Gaucho-Rocket-Project/Hotfire-Board/hotfire-board/production/bom.csv

Designator | Footprint | Quantity | Value | LCSC Part #
C1, C15, C18, C21, C26, C29, C30, C31, C36, C37, C38, C41, C42, C44, C45, C46, C47, C48, C49, C50, C51, C52, C53, C54, C55, C60, C61, C66, C67, C68, C74, C75, C76, C78, C79, C9 | 0402 | 36 | 0.1u
C10, C8 | 0805 | 2 | 220n
C11, C2, C20, C22, C24, C3, C5, C6, C72, C73, C77 | 1206 | 11 | 4.7u
C12, C14, C17, C39, C4, C43, C69, C70, C71, C80 | 0603 | 10 | 1u
C13 | 0402 | 1 | 270n
C16 | 0402 | 1 | 100p
C19 | 0603 | 1 | CFF
C23, C25, C27, C28, C32 | 1206 | 5 | 22u
C33, C34 | 0402 | 2 | 10p
C35 | 1210 | 1 | 10u
C40, C56, C57, C58, C59, C62, C63, C64, C65, C7 | 0402 | 10 | 10n
CR1 | Shottkey_Rev_Bat | 1 | B1100-13-F
CR3 | ESDPROTECTION | 1 | USBLC6-2SC6 | USBLC6-2SC6
CR4 | SWD_1_TVS | 1 | SMLVT3V3
CR5 | SWD_4_TVS | 1 | ESDALC6V1W5
CR6, CR7, CR8, CR9 | TVS_Input | 4 | SP1233-01ETG
D1, D12, D13, D14, D15, D16, D17, D18, D19, D2, D20, D21, D22, D23, D26, D27, D28, D29, D3, D30, D31, D32, D33, D34, D35, D36, D4, D5, D8, D9 | SD_ESD | 30 | TPD1E05U06DPYR
D10, D11, D6, D7 | dual_shottkey | 4 | BAT54S
D24 | 15V_TVS | 1 | SMBJ15A
D25 | 18V_TVS | 1 | SMBJ18A
F1 | fuse | 1 | SF-1206S100-2
J1 | AMASS_XT60-M_1x02_P7.20mm_Vertical | 1 | Conn_01x02
J10, J5, J7, J9 | 3-pin-jst | 4 | SM03B-GHS-TB
J11, J12, J13, J14 | screw_terminal | 4 | 1725656
J15 | PinSocket_1x08_P2.54mm_Vertical | 1 | Conn_01x08
J16 | PinSocket_2x06_P2.54mm_Vertical | 1 | C36191
J17 | newSD | 1 | 1040310811
J2 | 3x2_Header | 1 | BCS-103-L-D-TE
J3 | PinSocket_1x04_P2.54mm_Vertical | 1 | UART1
J4 | PinSocket_1x04_P2.54mm_Vertical | 1 | UART3
J6 | USB | 1 | USB4105-GF-A-060 | USB4105-GF-A-060
L1, L2 | 22uH | 2 | IHLP2525CZER220M5A
LED1, LED2, LED3, LED4, LED5, LED6 | red_LED | 6 | LTST-C190KRKT
R1, R14, R15, R28, R29, R35, R42, R61, R71, R79, R91, R92 | 0805 | 12 | 130
R10, R11, R6, R65, R66, R74 | 0402 | 6 | 100k
R12, R37, R38, R39, R40, R63, R69, R72, R75, R76, R77, R78, R9 | 0402 | 13 | 10k
R13 | 0603 | 1 | 400 | PAT0603E4000BST1
R16, R17, R18, R19, R20, R21 | 0402 | 6 | 22
R2, R68 | 0402 | 2 | 590
R22, R23, R24, R27, R32, R33 | 0402 | 6 | 47k
R25, R26, R34, R41 | 1206 | 4 | 20
R3, R4 | 0603 | 2 | 5.1k | 0603WAF5101T5E
R30, R31, R36, R43, R67, R70, R73 | 0402 | 7 | 4.7k
R44, R45, R46, R47, R48, R49, R50, R51, R52, R53, R54, R55, R56, R57, R58, R59, R60, R80, R81, R82, R83, R84, R85, R86, R87, R88, R89, R90 | 0402 | 28 | 100
R5 | 0402 | 1 | 43.2k
R62, R64 | 0402 | 2 | 68.1k
R7 | 0402 | 1 | 24.9k
R8 | 1206 | 1 | 1.3k
SW1 | SWITCH | 1 | RESET
SW2 | SWITCH | 1 | BOOT
U1 | 3.3V_Buck | 1 | LMR36006BRNXR
U10 | Boost_Shottkey | 1 | SS34
U11 | 4-16-Multiplexer | 1 | CD74HC154M96
U12 | eFuse | 1 | TPS26600PWPR
U2 | 15V_Boost | 1 | TPS55340PWPR
U3 | STM32 | 1 | STM32L496RET6
U4 | PowerMUXER. | 1 | TPS2113APW
U5 | newLDO | 1 | TLV75533PDRVR
U6, U7, U8, U9 | MAX | 4 | MAX31856MUD+
Y1 | Crystal_SMD_3225-4Pin_3.2x2.5mm | 1 | 16MHz
