Gaucho-Rocket-Project/Hotfire-Board/hotfire-board/Hotfire-Board/Project Libraries/My3DModels/18V_TVS.stp

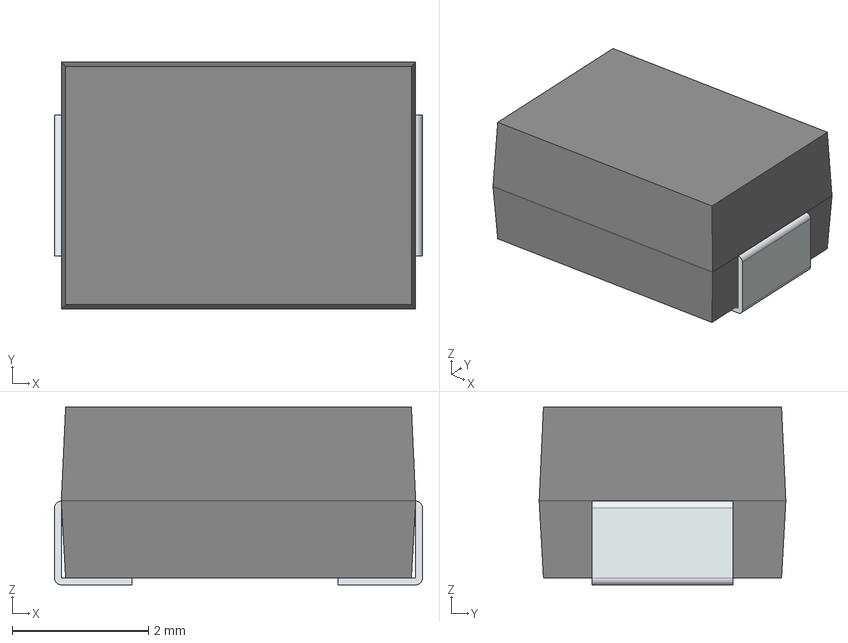
[picture p35: CAD file, 2026-10-14]
hotfire-board/Hotfire-Board/Project Libraries/My3DModels/18V_TVS.stp
5.40 x 3.62 x 2.61 mm
FilletPin1
FilletPin2
