Gaucho-Rocket-Project/Hotfire-Board/hotfire-board/Project Libraries/My3DModels/Boost_Shottkey.step

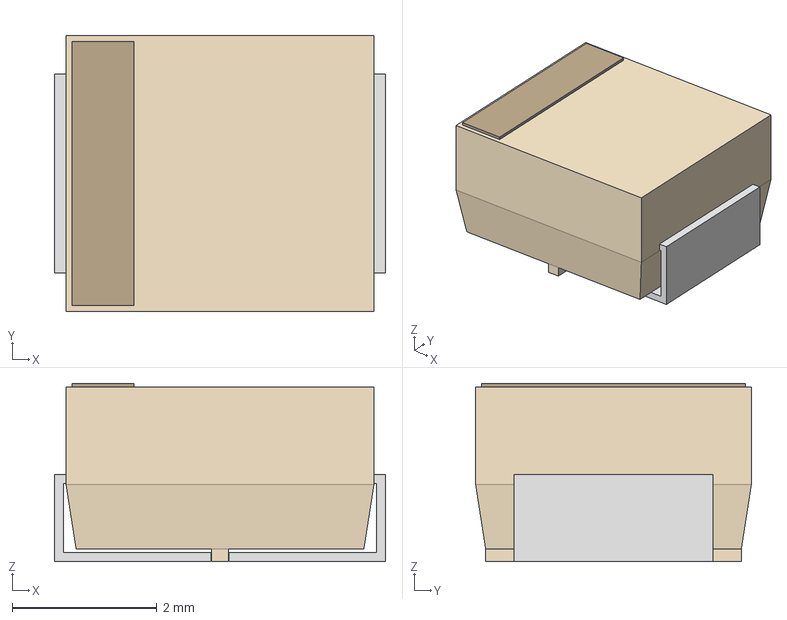
[picture p36: CAD file, 2026-11-07]
hotfire-board/Project Libraries/My3DModels/Boost_Shottkey.step
4.57 x 3.81 x 2.46 mm
