Gaucho-Rocket-Project/Hotfire-Board/hotfire-board/Hotfire-Board/Project Libraries/My3DModels/SD_ESD.step

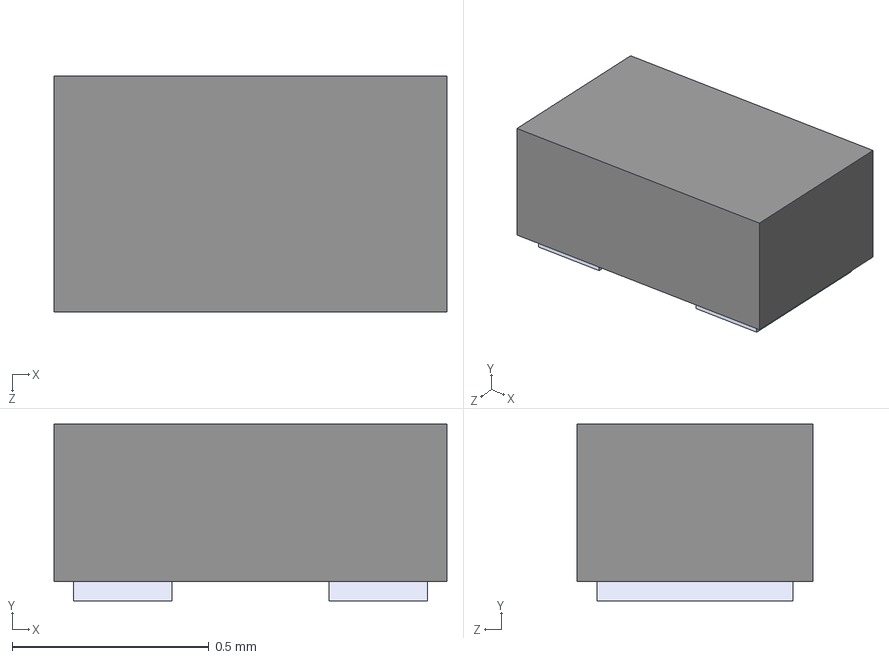
[picture p37: CAD file, 2026-10-08]
hotfire-board/Hotfire-Board/Project Libraries/My3DModels/SD_ESD.step
1.00 x 0.45 x 0.6 mm
