Gaucho-Rocket-Project/Hotfire-Board/hotfire-board/Project Libraries/My3DModels/TVS_Input.step

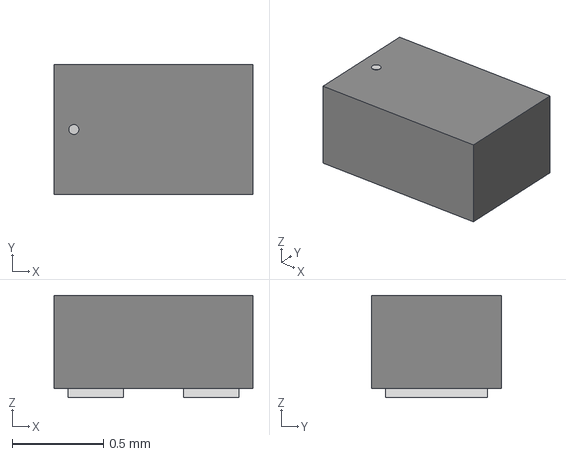
[picture p38: CAD file, 2026-10-08]
hotfire-board/Project Libraries/My3DModels/TVS_Input.step
1.09 x 0.712 x 0.561 mm
