Gaucho-Rocket-Project/Hotfire-Board/hotfire-board/Hotfire-Board/Project Libraries/My3DModels/dual_shottkey.STEP

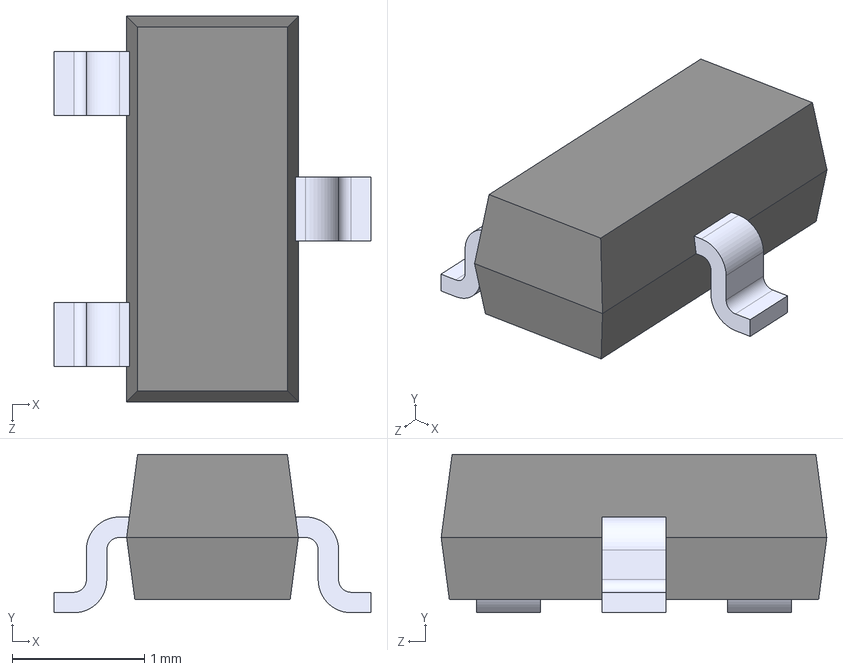
[picture p39: CAD file, 2026-10-08]
hotfire-board/Hotfire-Board/Project Libraries/My3DModels/dual_shottkey.STEP
2.40 x 1.20 x 2.92 mm
