Gaucho-Rocket-Project/Hotfire-Board/hotfire-board/Project Libraries/My3DModels/ESDPROTECTION.step

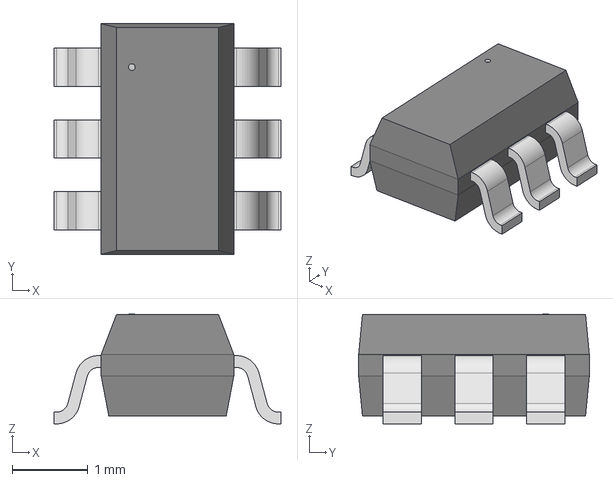
[picture p40: CAD file, 2026-10-07]
hotfire-board/Project Libraries/My3DModels/ESDPROTECTION.step
3.00 x 3.05 x 1.45 mm
