Gaucho-Rocket-Project/Hotfire-Board/hotfire-board/Hotfire-Board/Project Libraries/My3DModels/SD_Card.step

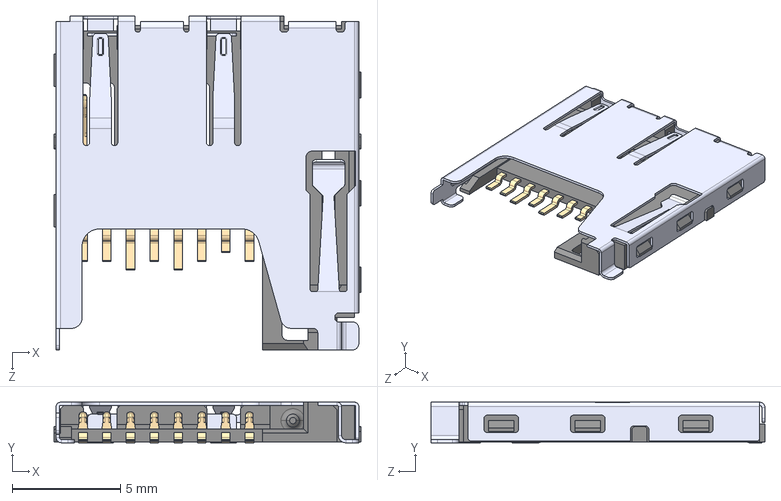
[picture p41: CAD file, 2026-10-08]
hotfire-board/Hotfire-Board/Project Libraries/My3DModels/SD_Card.step
14.2 x 1.88 x 15.4 mm
