Gaucho-Rocket-Project/Hotfire-Board/hotfire-board/Project Libraries/My3DModels/2x3_Header.stp

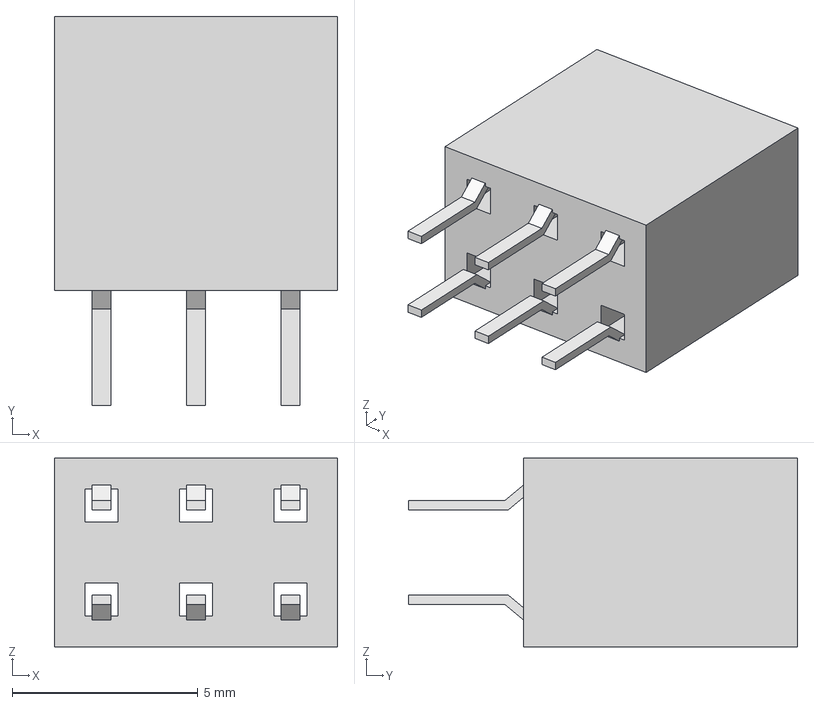
[picture p42: CAD file, 2026-10-07]
hotfire-board/Project Libraries/My3DModels/2x3_Header.stp
7.62 x 10.5 x 5.08 mm
BCS-103-D-TE_socket
C-95-01-03-L-D-TE
C-95-01-03-L-D-TE2
