Gaucho-Rocket-Project/Hotfire-Board/hotfire-board/Hotfire-Board/Project Libraries/My3DModels/red_LED.step

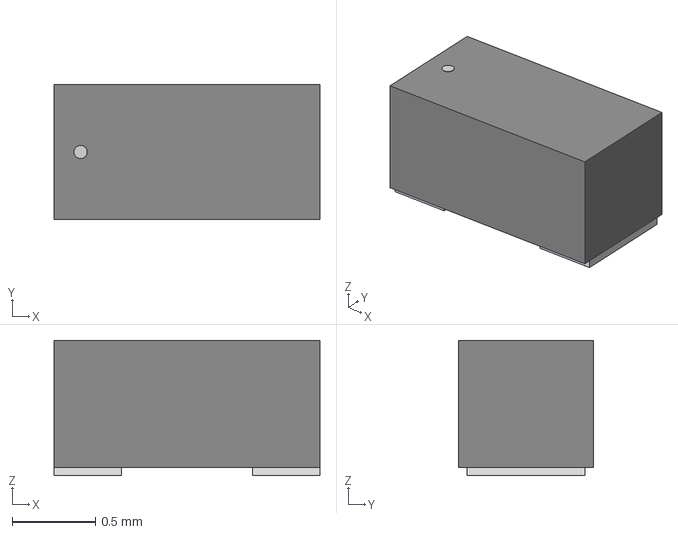
[picture p43: CAD file, 2026-10-07]
hotfire-board/Hotfire-Board/Project Libraries/My3DModels/red_LED.step
1.60 x 0.812 x 0.815 mm
