Gaucho-Rocket-Project/Hotfire-Board/hotfire-board/Hotfire-Board/Project Libraries/My3DModels/USB.step

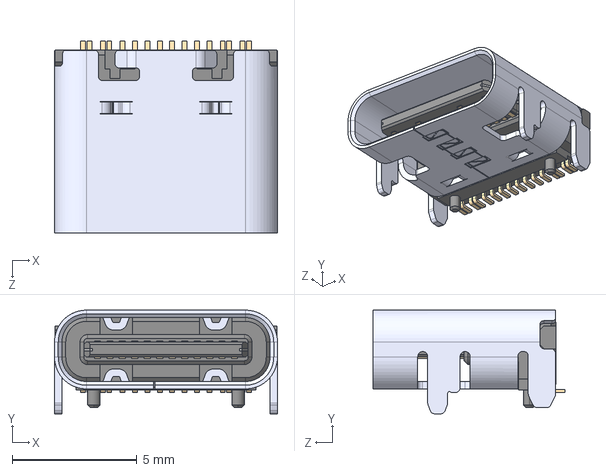
[picture p44: CAD file, 2026-10-07]
hotfire-board/Hotfire-Board/Project Libraries/My3DModels/USB.step
8.94 x 4.16 x 7.71 mm
