Gaucho-Rocket-Project/Hotfire-Board/hotfire-board/Project Libraries/My3DModels/Switch.step

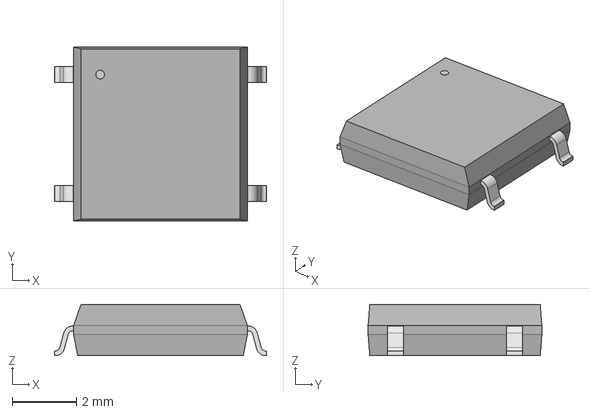
[picture p45: CAD file, 2026-10-07]
hotfire-board/Project Libraries/My3DModels/Switch.step
6.60 x 5.41 x 1.60 mm
