Gaucho-Rocket-Project/Hotfire-Board/hotfire-board/Hotfire-Board/Project Libraries/My3DModels/15uH_Inductor.step

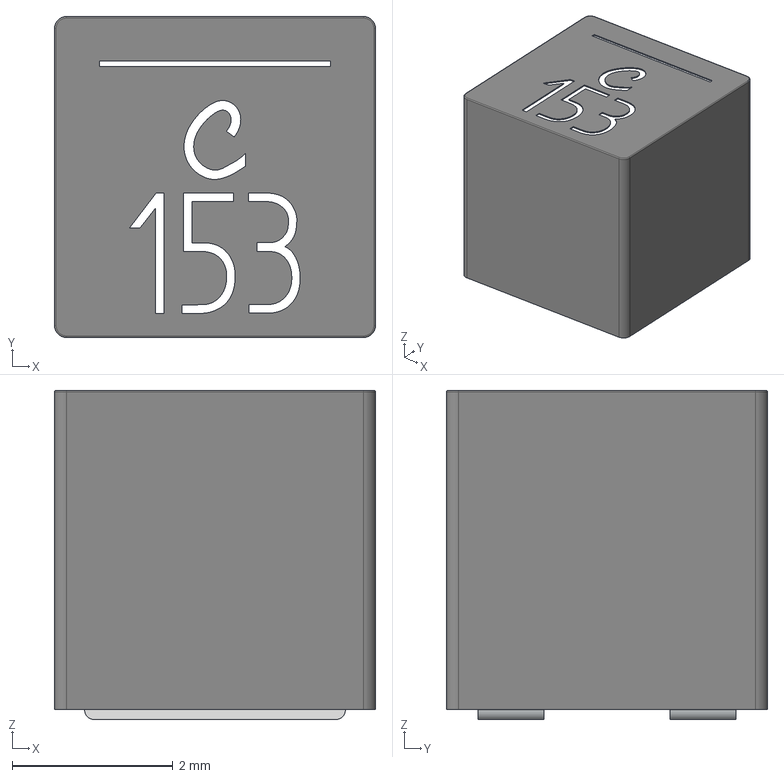
[picture p46: CAD file, 2026-10-07]
hotfire-board/Hotfire-Board/Project Libraries/My3DModels/15uH_Inductor.step
4.00 x 4.00 x 4.10 mm
