Gaucho-Rocket-Project/Hotfire-Board/hotfire-board/Project Libraries/My3DModels/fuse.stp

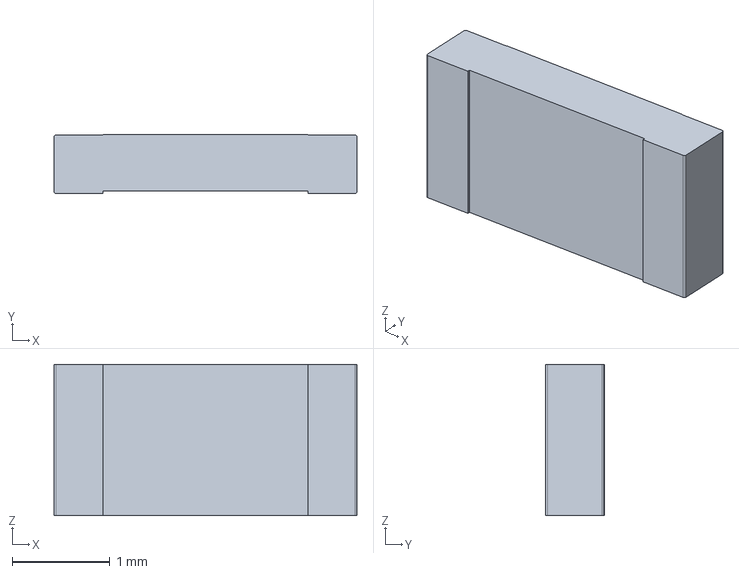
[picture p47: CAD file, 2026-10-07]
hotfire-board/Project Libraries/My3DModels/fuse.stp
3.10 x 0.605 x 1.55 mm
