Gaucho-Rocket-Project/Hotfire-Board/hotfire-board/Hotfire-Board/Project Libraries/My3DModels/PowerMUXER.stp

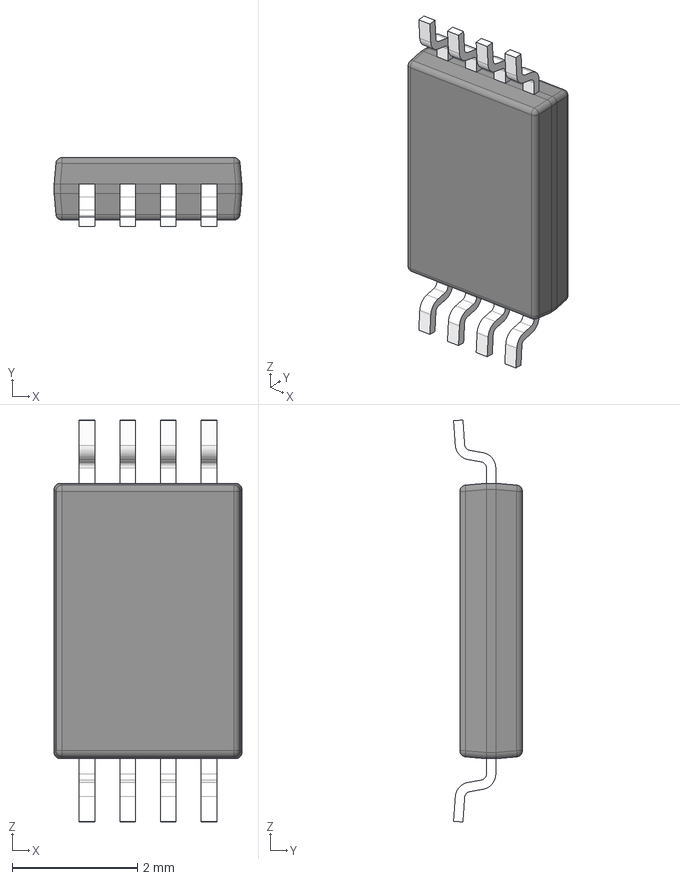
[picture p48: CAD file, 2026-10-07]
hotfire-board/Hotfire-Board/Project Libraries/My3DModels/PowerMUXER.stp
3.00 x 1.10 x 6.42 mm
BODY-SO
LEAD-SO x 8
PIN1-ID
