Gaucho-Rocket-Project/Hotfire-Board/hotfire-board/Project Libraries/My3DModels/SWD_1_TVS.step

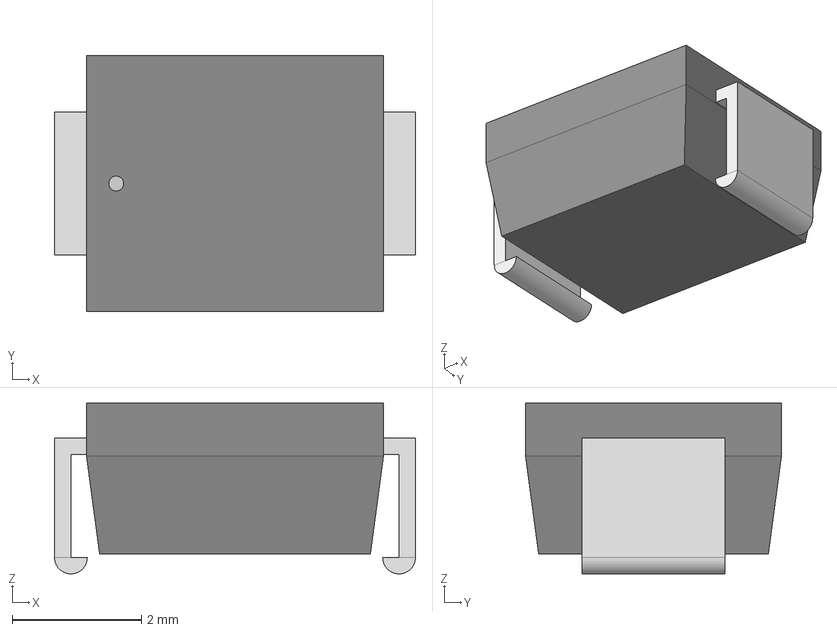
[picture p49: CAD file, 2026-10-07]
hotfire-board/Project Libraries/My3DModels/SWD_1_TVS.step
5.59 x 3.96 x 2.64 mm
