Gaucho-Rocket-Project/Hotfire-Board/hotfire-board/Hotfire-Board/Project Libraries/My3DModels/28V_TVS.step

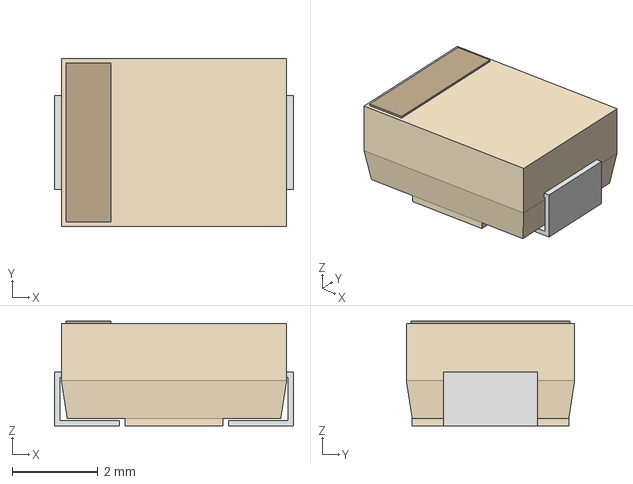
[picture p50: CAD file, 2026-10-07]
hotfire-board/Hotfire-Board/Project Libraries/My3DModels/28V_TVS.step
5.59 x 3.94 x 2.45 mm
