Gaucho-Rocket-Project/Hotfire-Board/hotfire-board/Hotfire-Board/Project Libraries/My3DModels/Shottkey_Rev_Bat.step

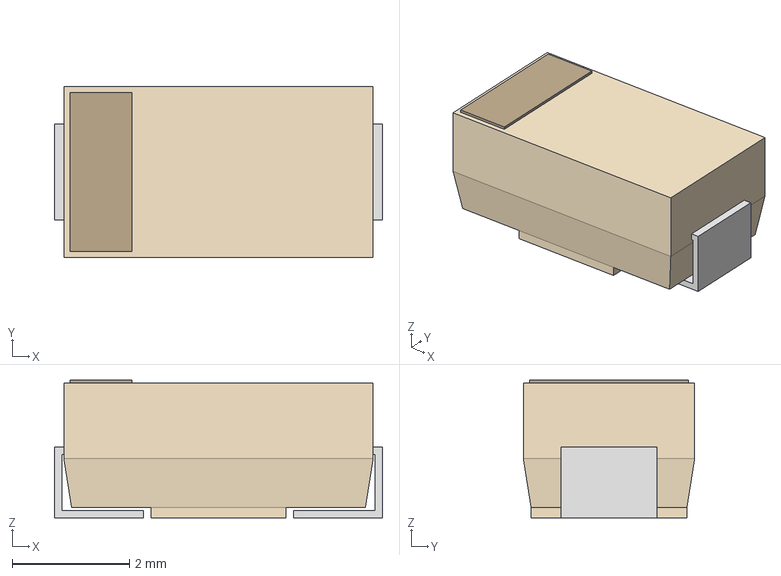
[picture p51: CAD file, 2026-10-07]
hotfire-board/Hotfire-Board/Project Libraries/My3DModels/Shottkey_Rev_Bat.step
5.59 x 2.92 x 2.35 mm
