Gaucho-Rocket-Project/Hotfire-Board/hotfire-board/Hotfire-Board/Project Libraries/My3DModels/MAX.step

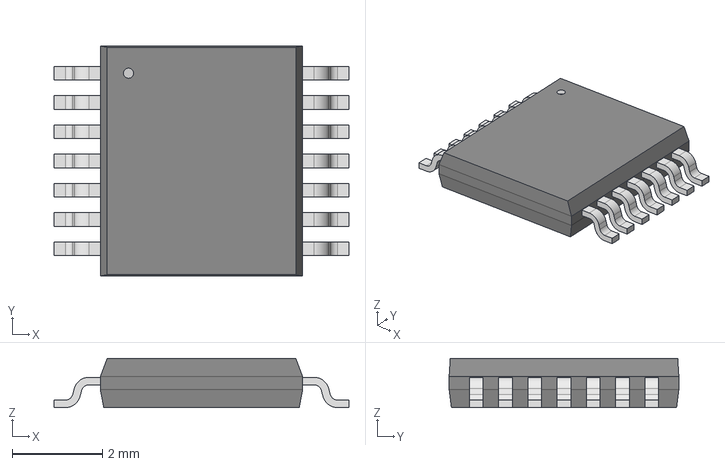
[picture p52: CAD file, 2026-10-07]
hotfire-board/Hotfire-Board/Project Libraries/My3DModels/MAX.step
6.55 x 5.11 x 1.09 mm
