Gaucho-Rocket-Project/Hotfire-Board/hotfire-board/Hotfire-Board/Project Libraries/My3DModels/SWD_4_TVS.step

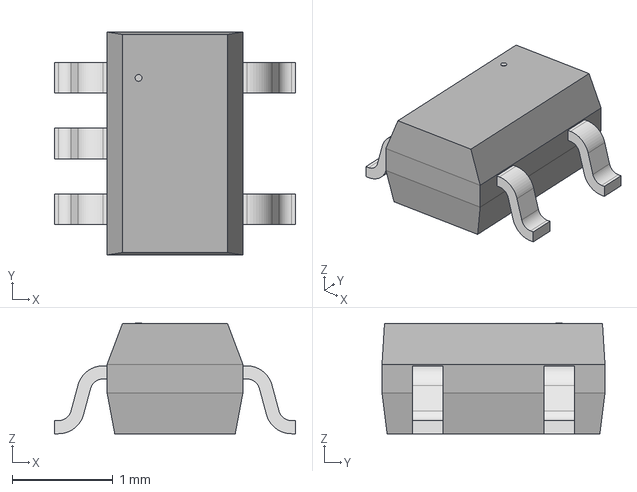
[picture p53: CAD file, 2026-10-07]
hotfire-board/Hotfire-Board/Project Libraries/My3DModels/SWD_4_TVS.step
2.39 x 2.21 x 1.09 mm
