Gaucho-Rocket-Project/Hotfire-Board/hotfire-board/Hotfire-Board/Project Libraries/My3DModels/3.3V_Buck.stp

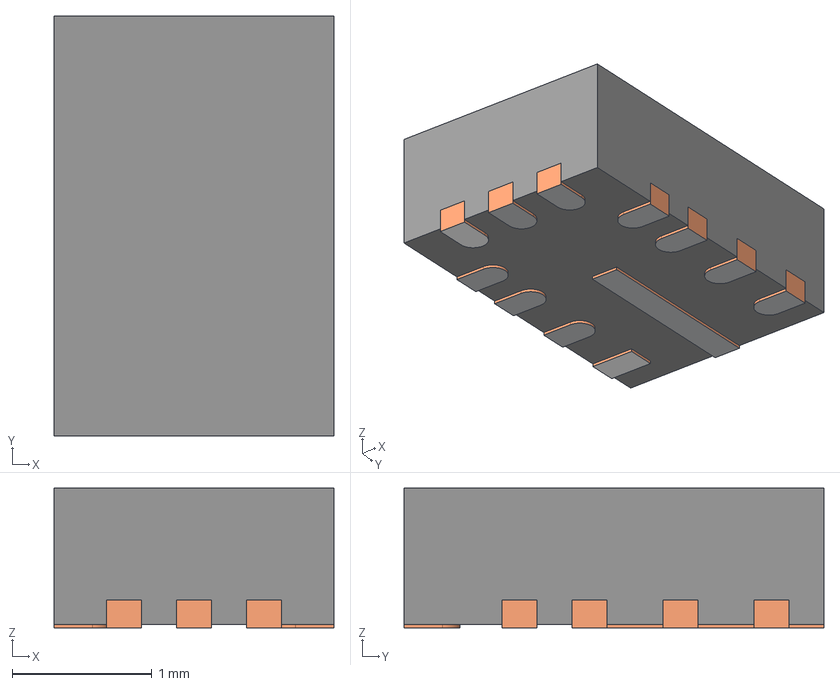
[picture p54: CAD file, 2026-10-07]
hotfire-board/Hotfire-Board/Project Libraries/My3DModels/3.3V_Buck.stp
2.00 x 3.00 x 1.00 mm
FRAME-RNX0012A
BODY-QFN
PIN1-ID
