Gaucho-Rocket-Project/Hotfire-Board/hotfire-board/Hotfire-Board/Project Libraries/My3DModels/LDO.stp

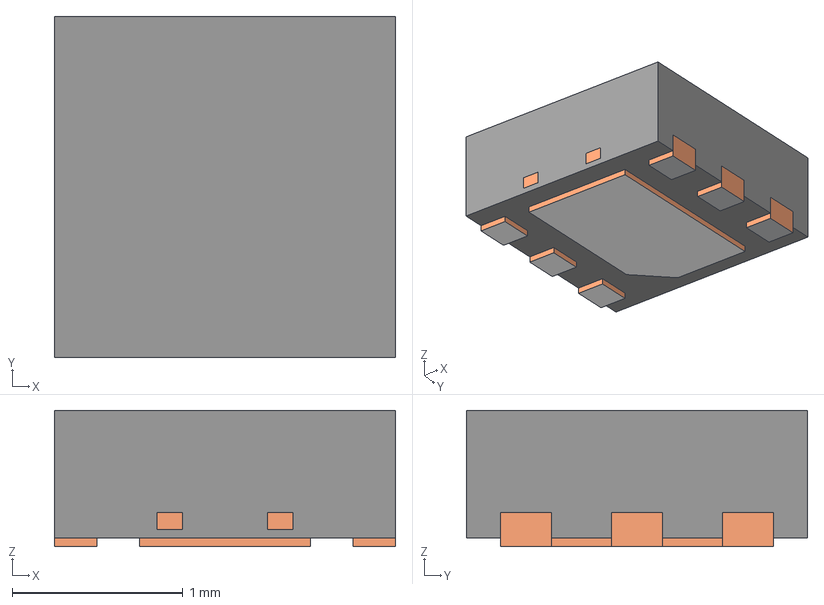
[picture p55: CAD file, 2026-10-07]
hotfire-board/Hotfire-Board/Project Libraries/My3DModels/LDO.stp
2.00 x 2.00 x 0.8 mm
BODY-SON
FRAME-DRV0006A
PIN1-ID
