Gaucho-Rocket-Project/Hotfire-Board/hotfire-board/Hotfire-Board/Project Libraries/My3DModels/STM32.step

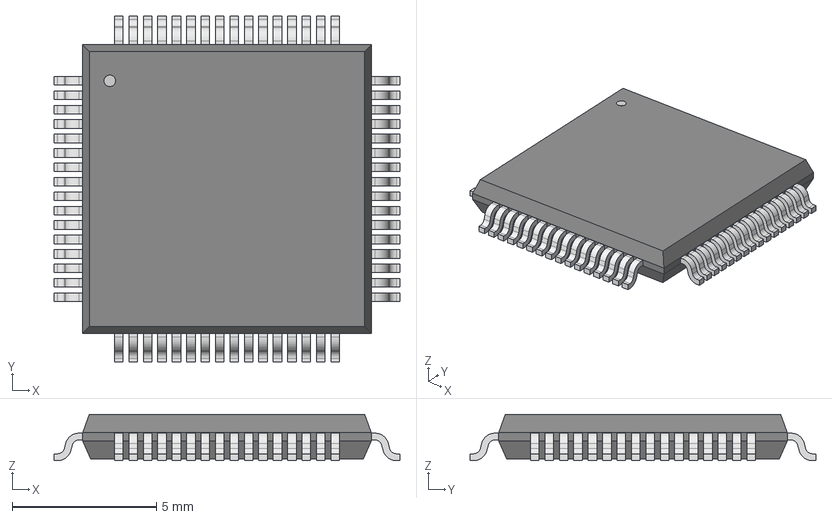
[picture p56: CAD file, 2026-10-07]
hotfire-board/Hotfire-Board/Project Libraries/My3DModels/STM32.step
12.0 x 12.0 x 1.60 mm
