Gaucho-Rocket-Project/Hotfire-Board/(list of files, cad)

Other CAD files:
hotfire-board/Project Libraries/My3DModels/screw_terminal.step
