Gaucho-Rocket-Project/Hotfire-Board/hotfire-board/Hotfire-Board.kicad_pcb

## KiCad design hotfire-board/Hotfire-Board.kicad_pcb (2026-11-07)

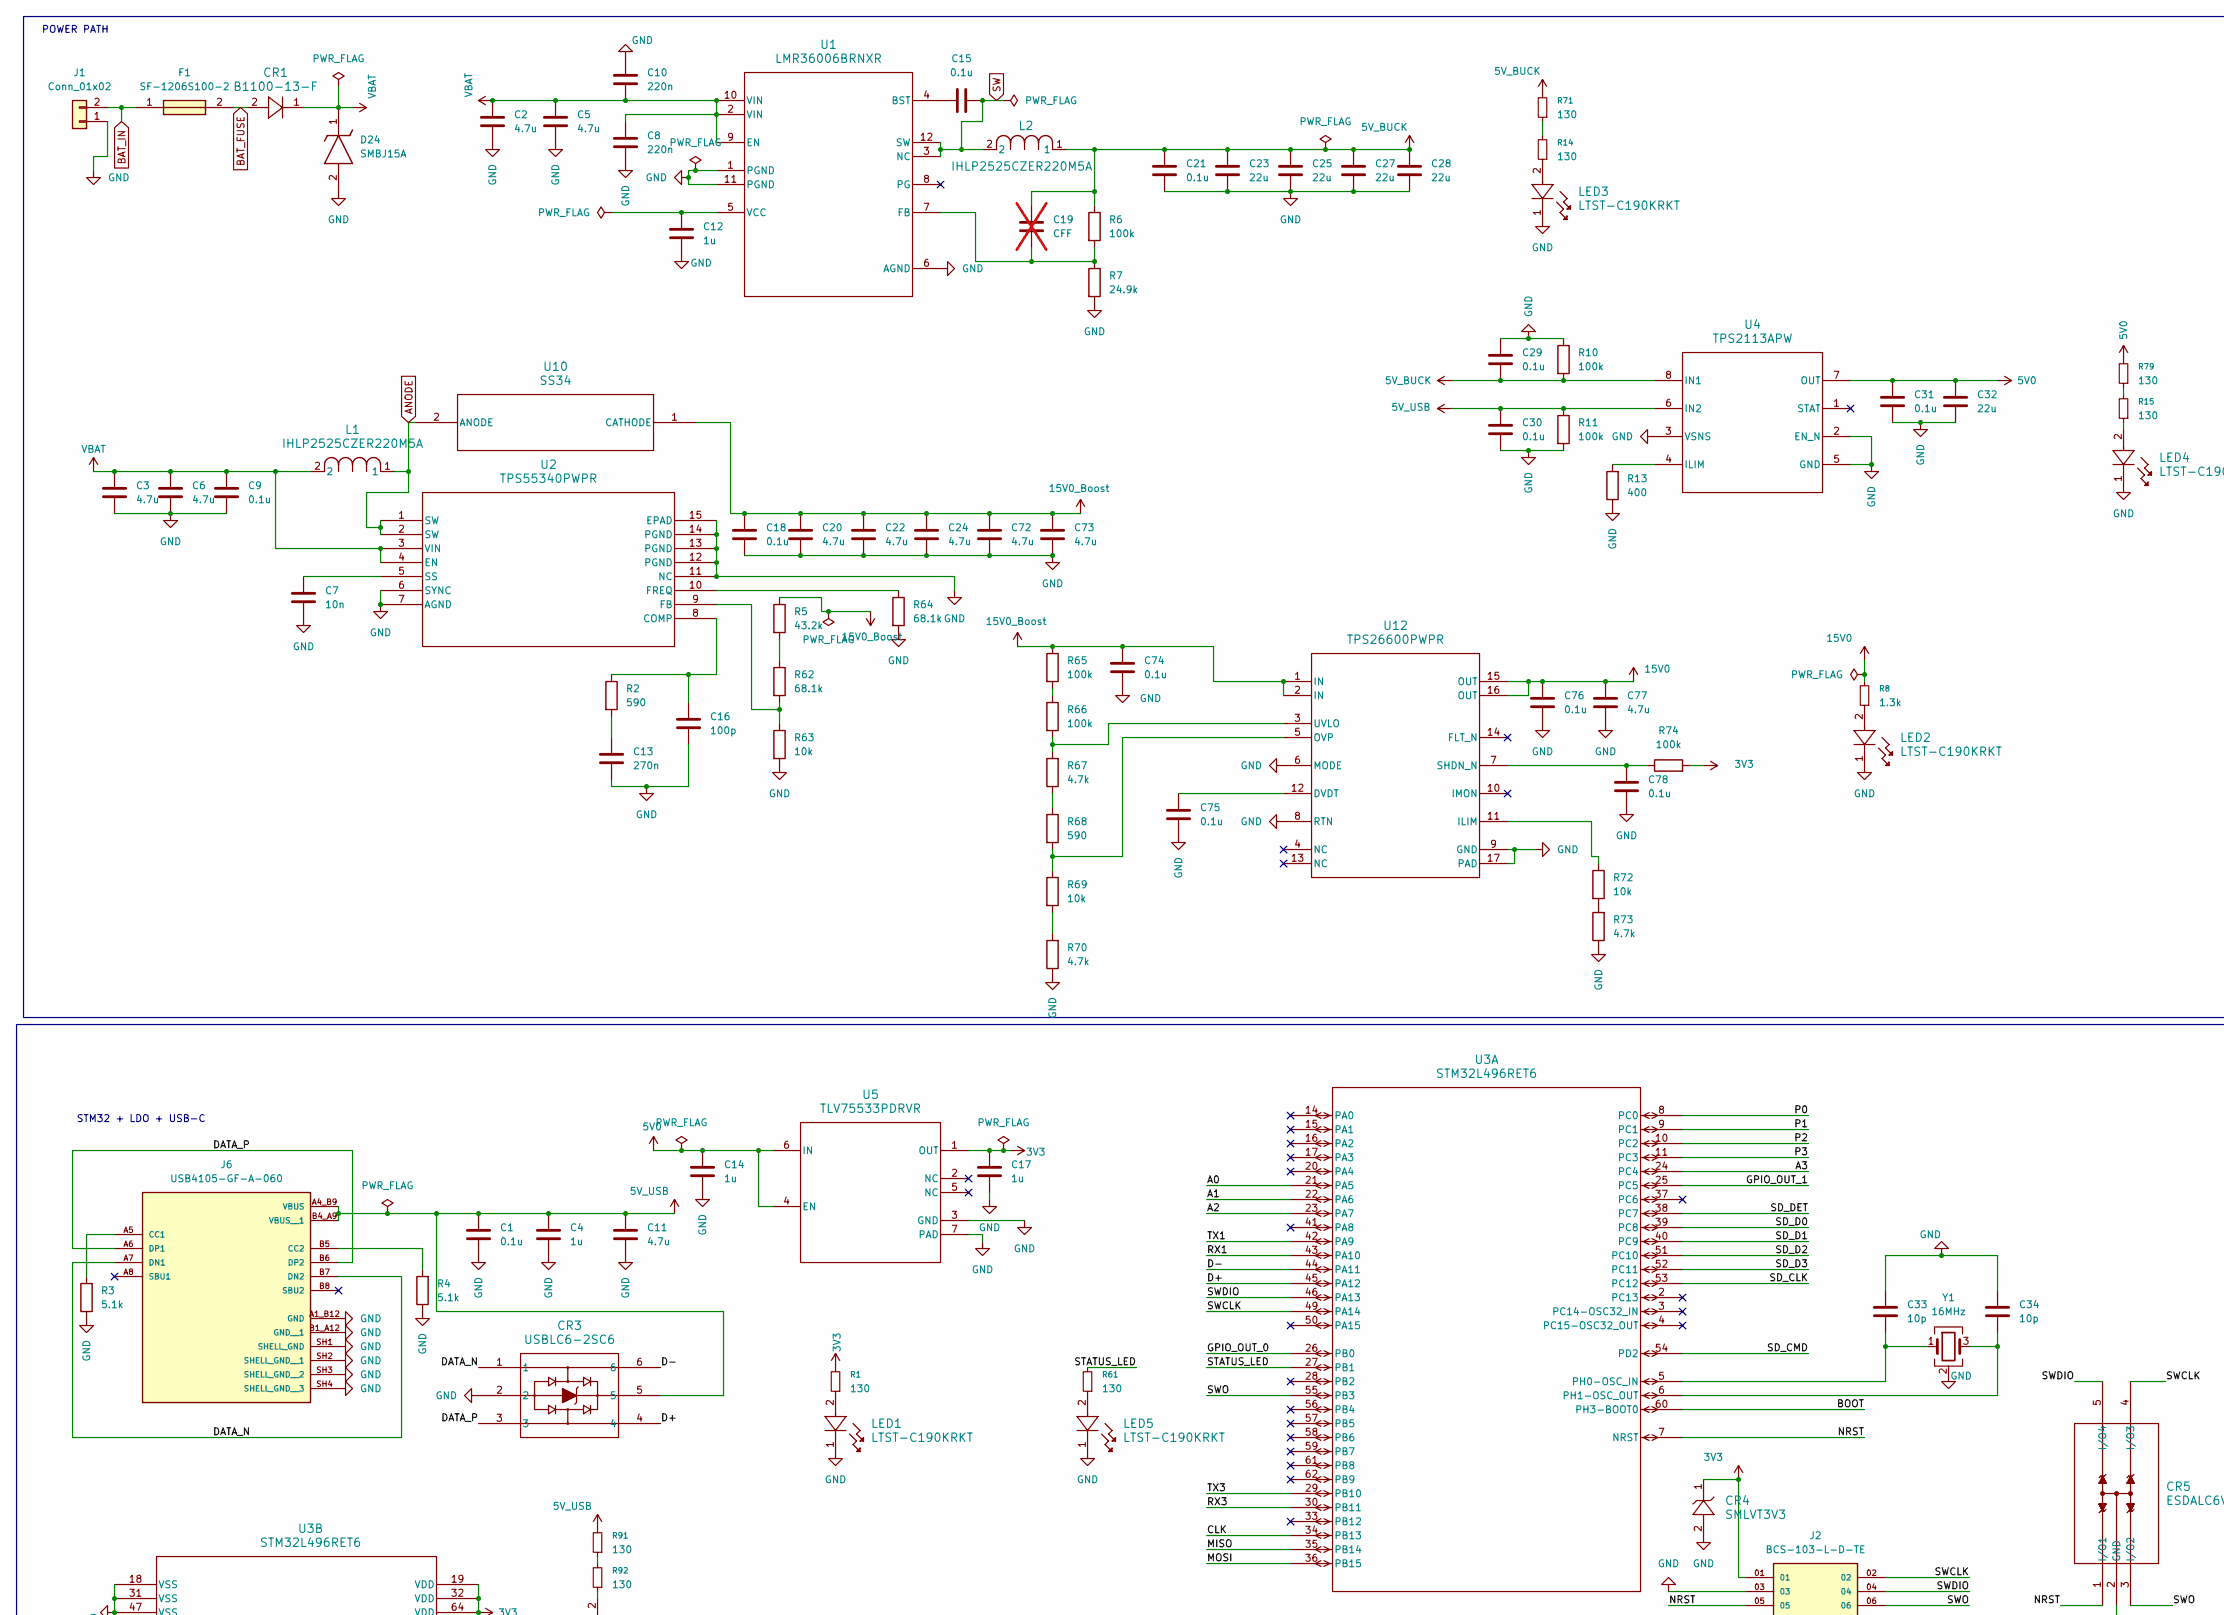
[picture p57: schematic Hotfire-Board.kicad_sch, part in row 1, column 1]

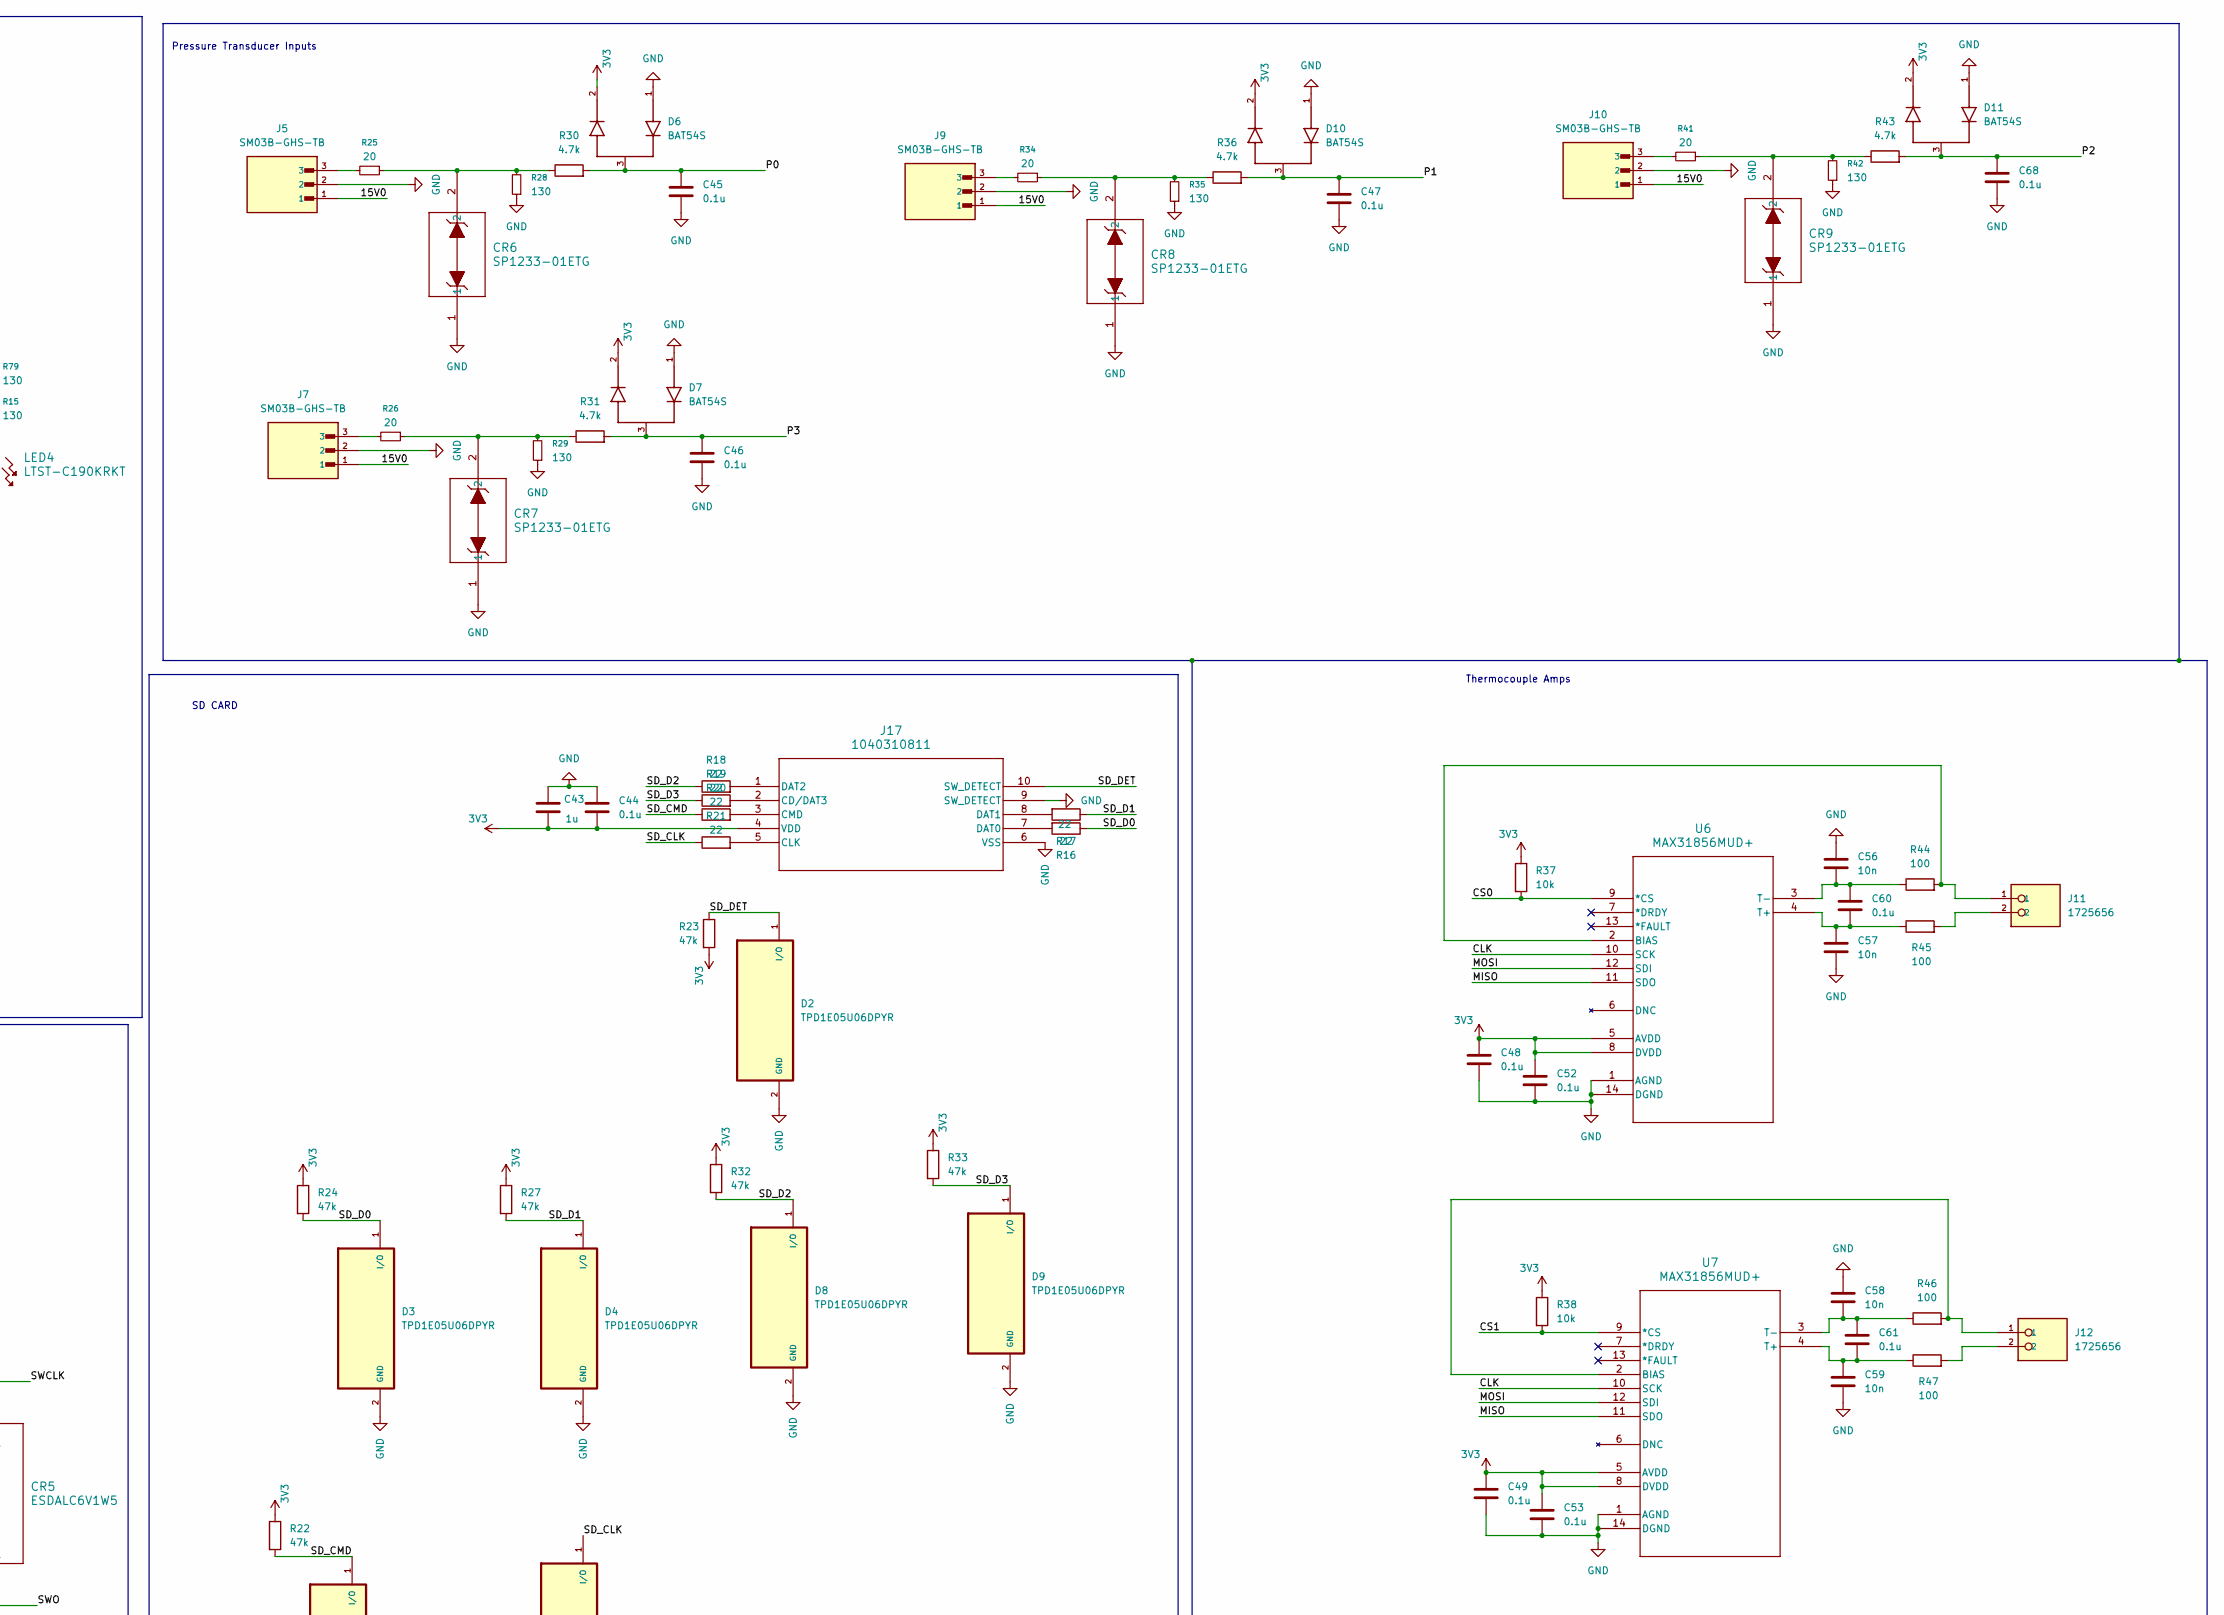
[picture p58: schematic Hotfire-Board.kicad_sch, part in row 1, column 2]

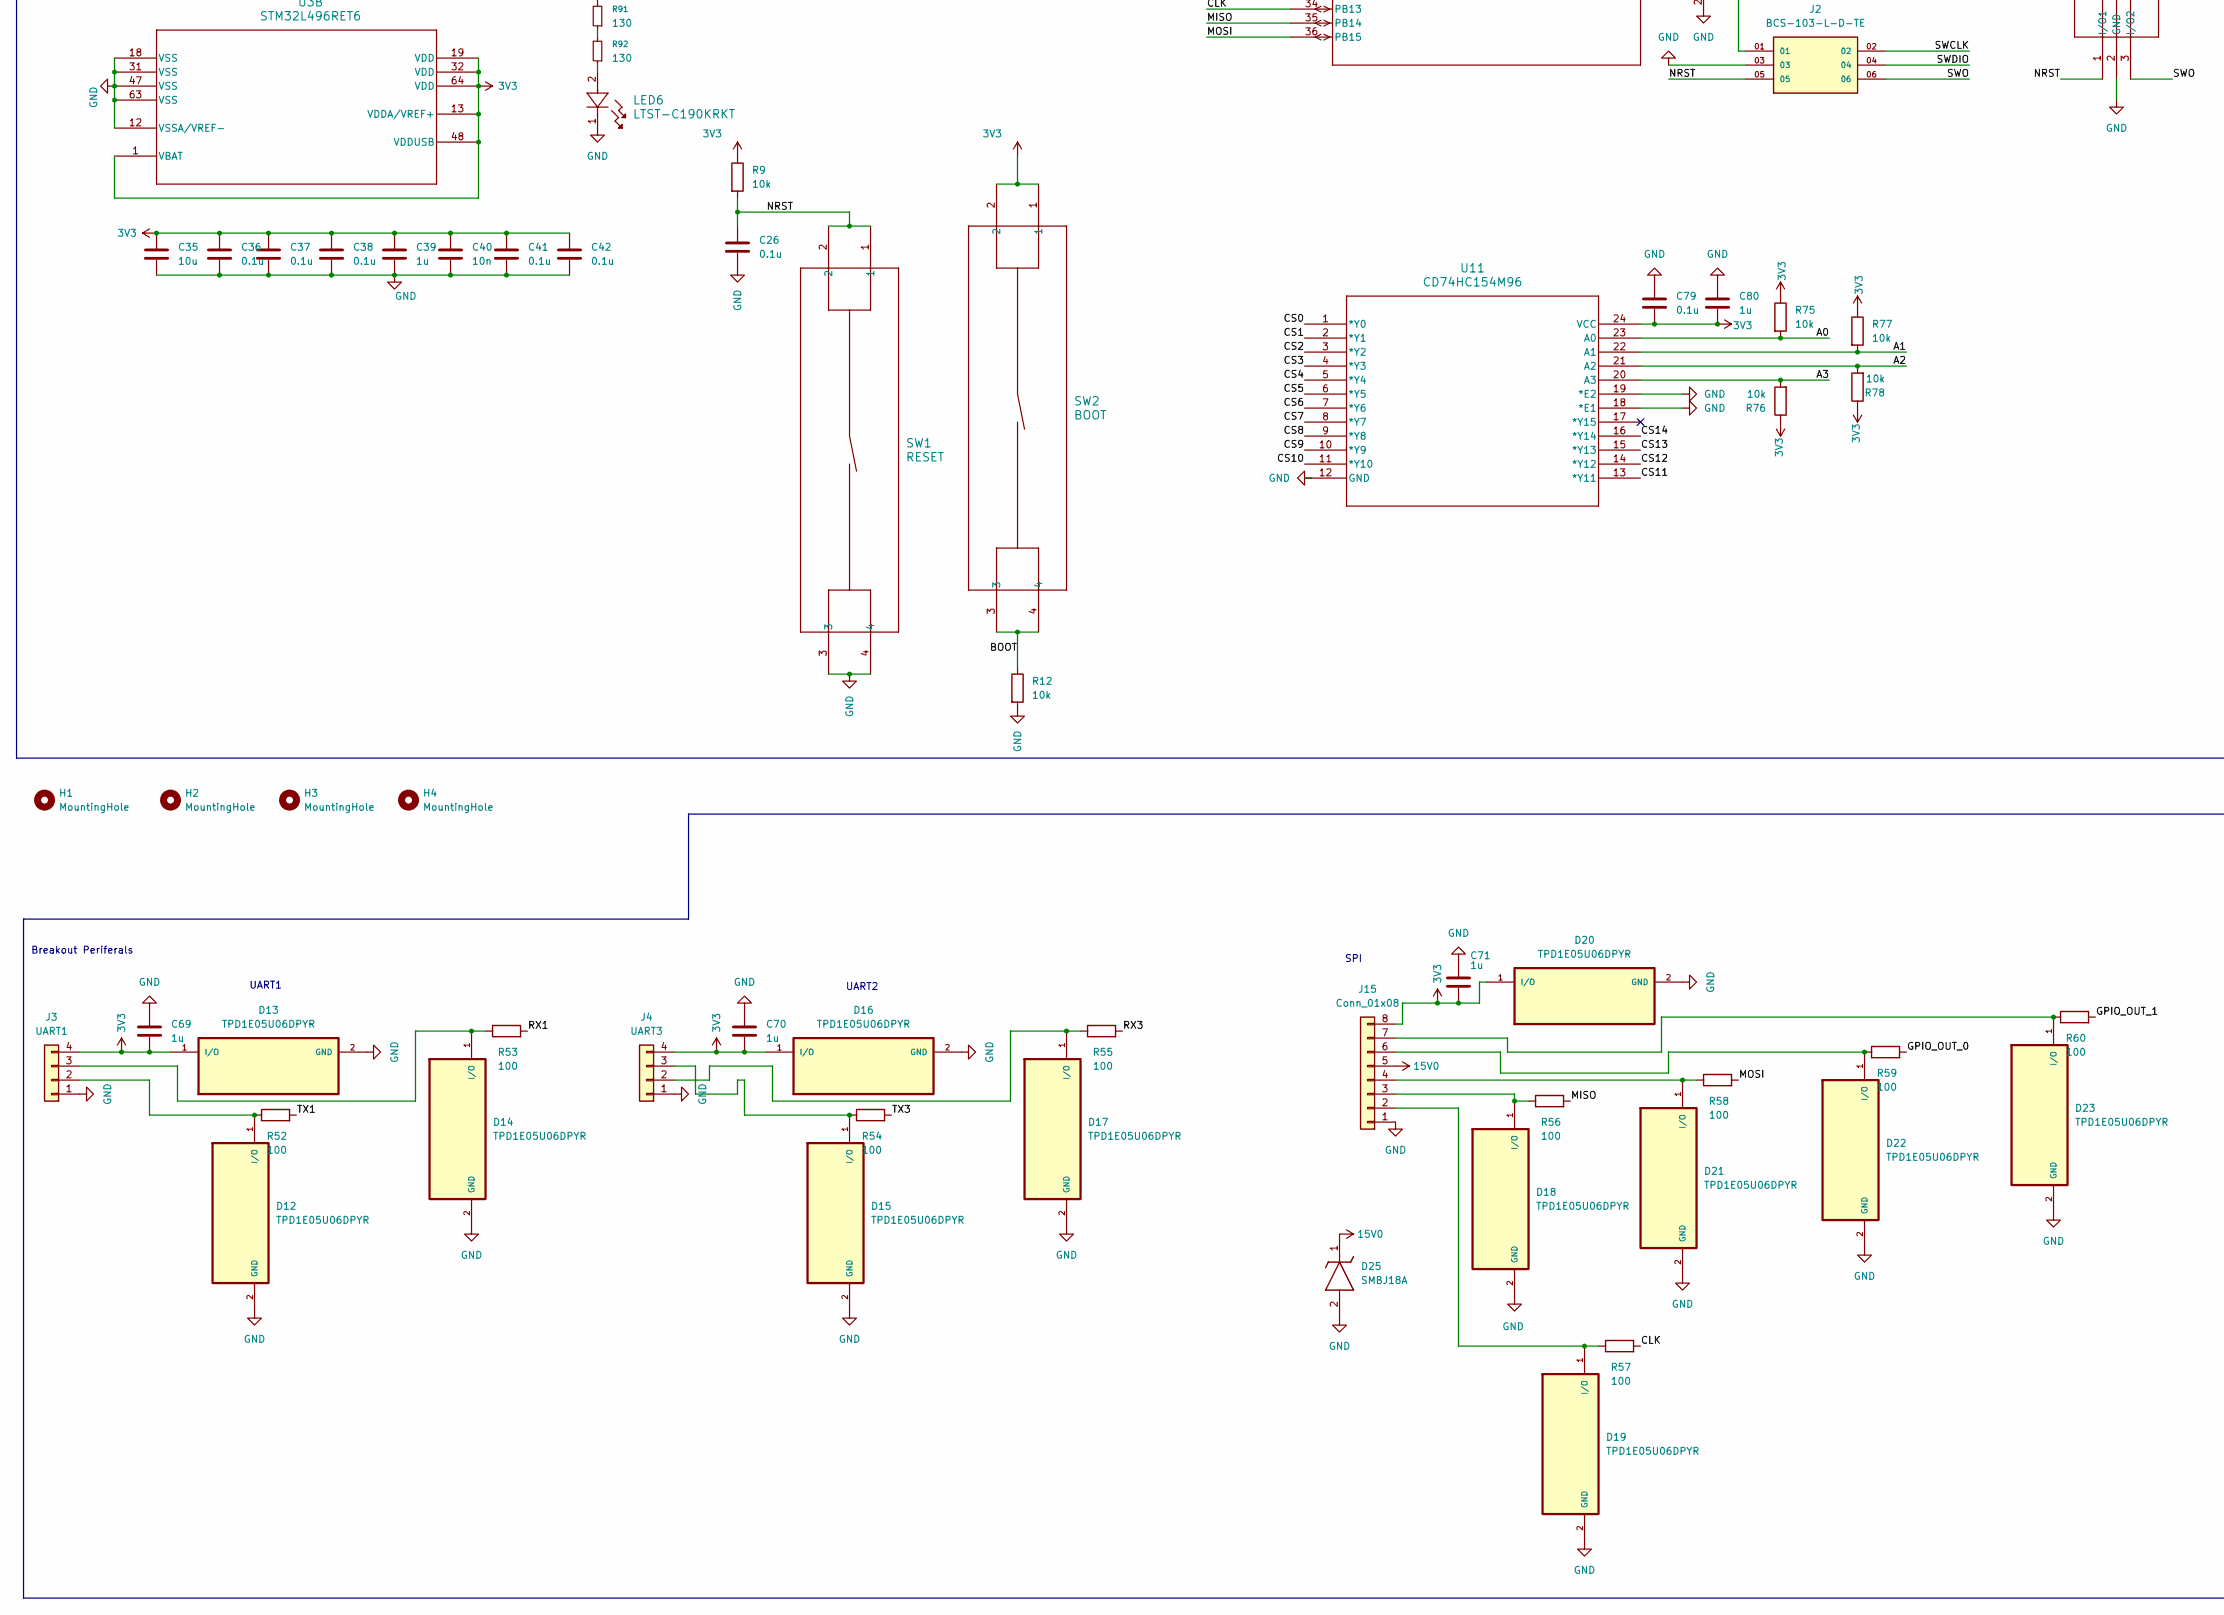
[picture p59: schematic Hotfire-Board.kicad_sch, part in row 2, column 1]

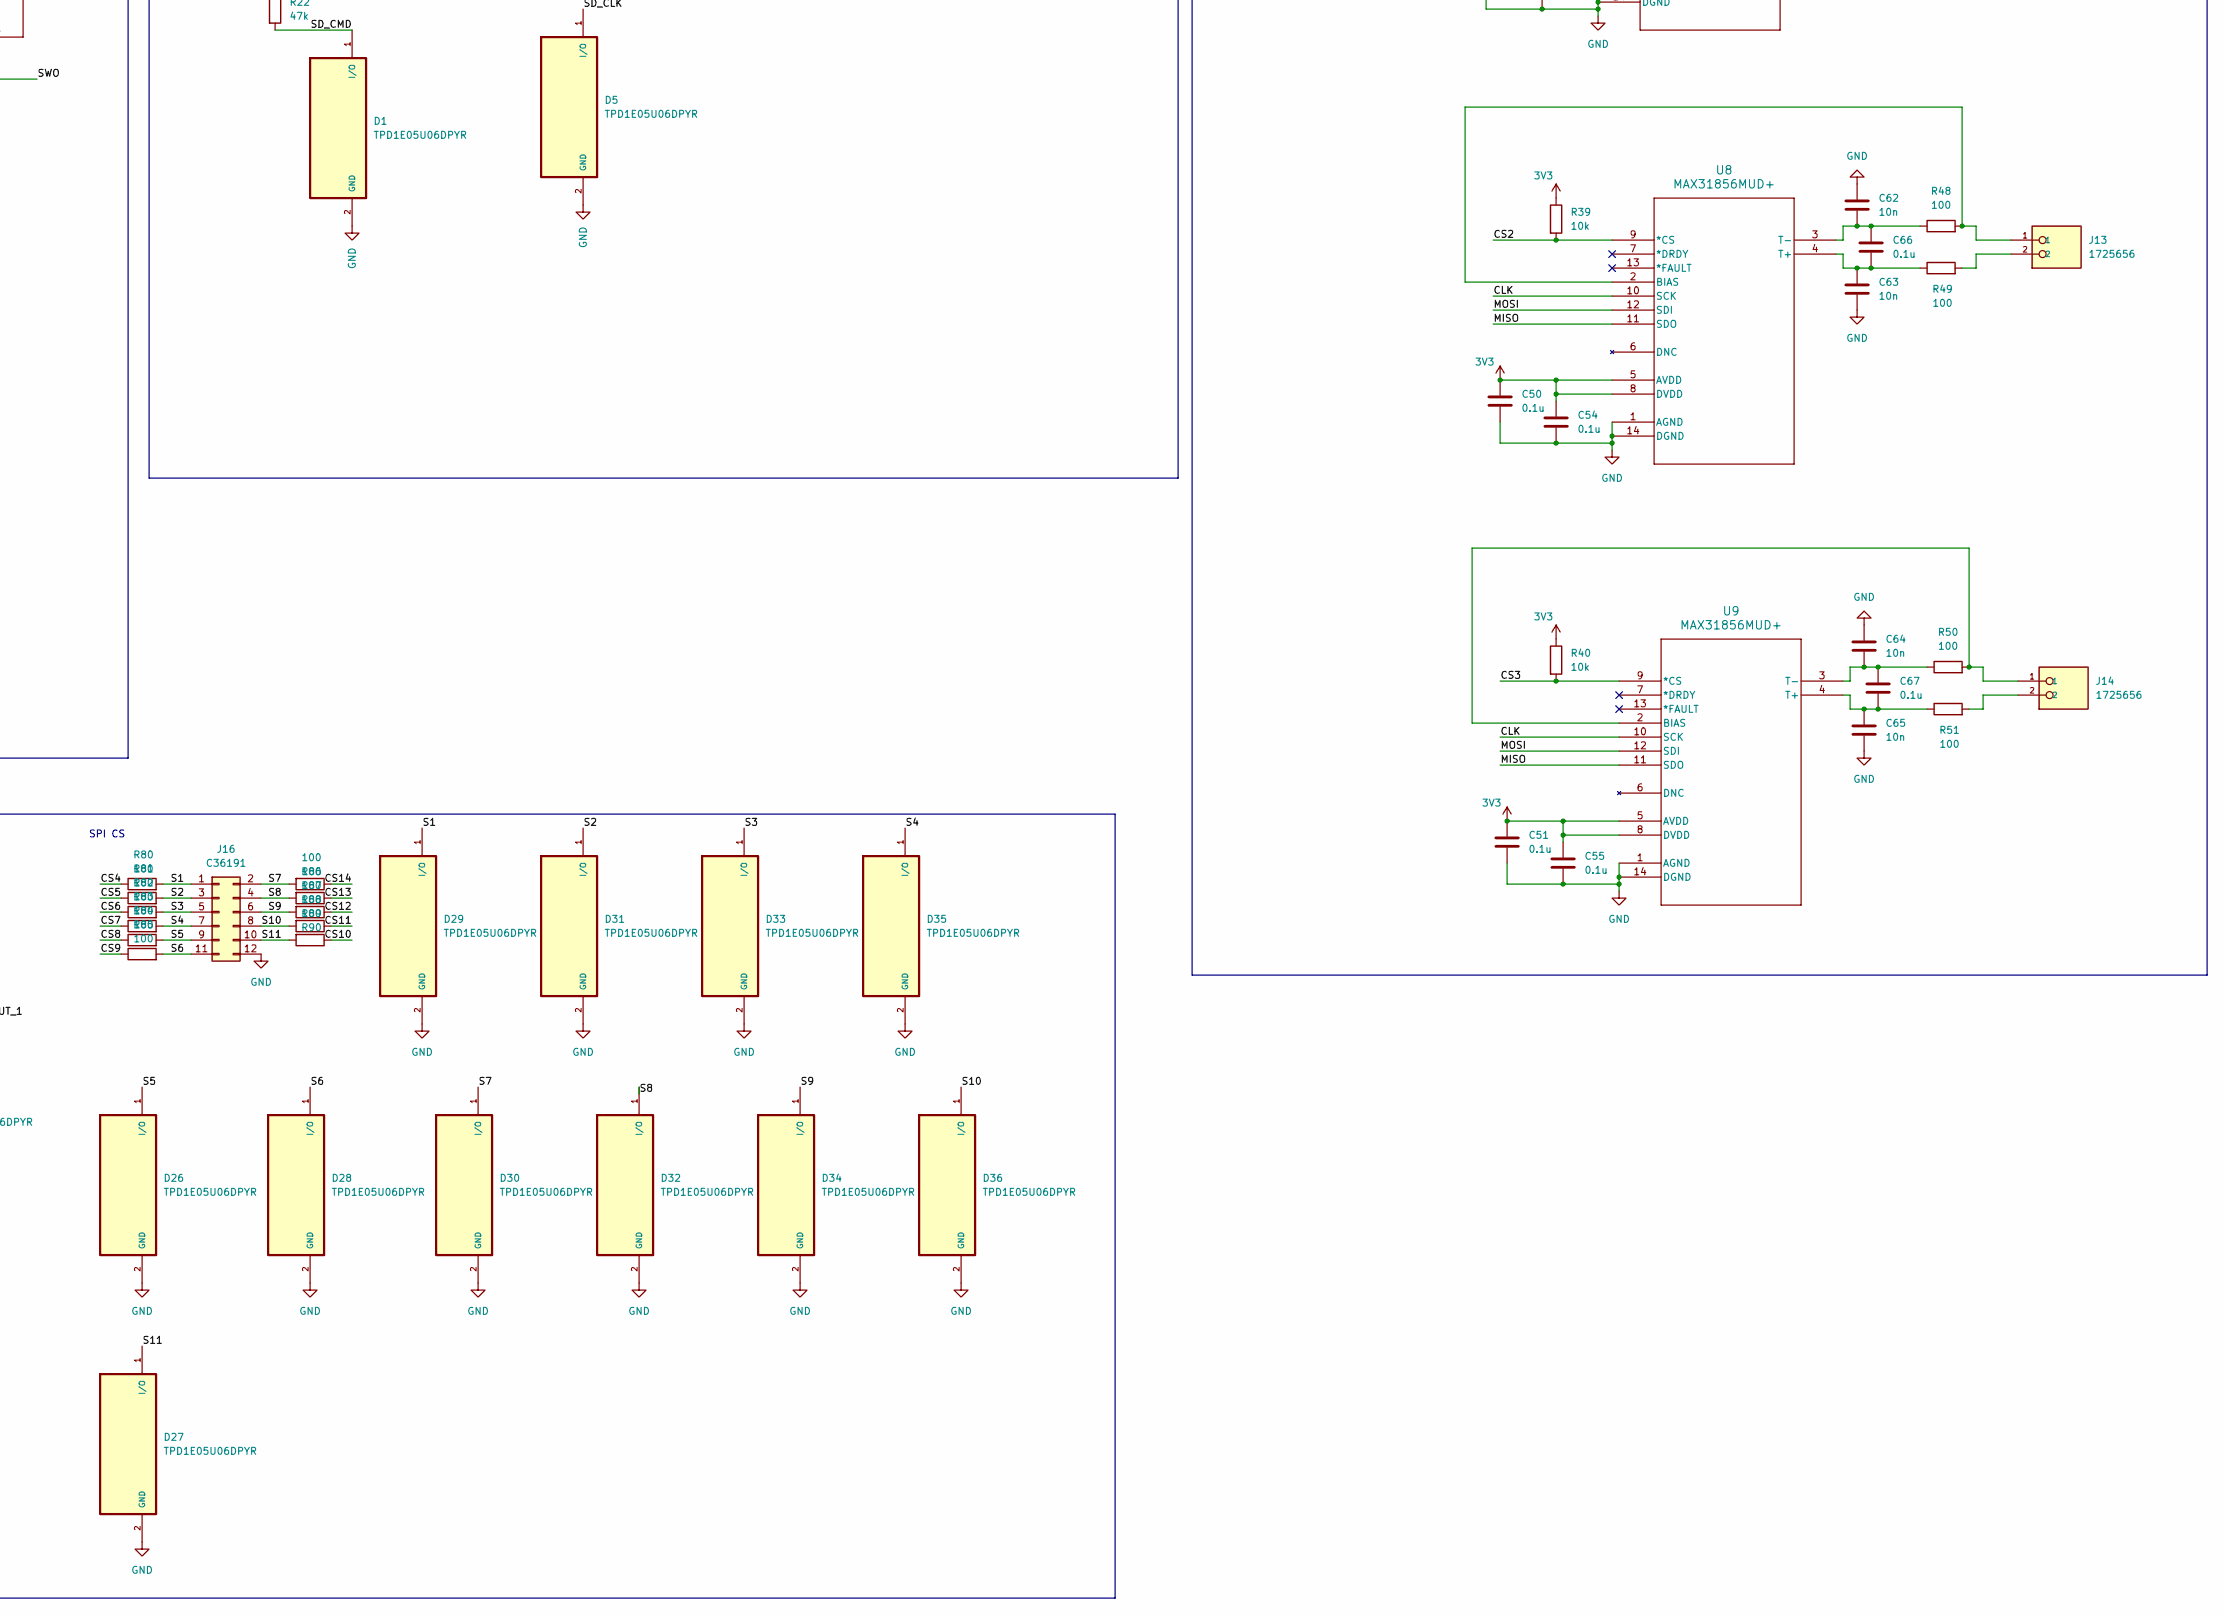
[picture p60: schematic Hotfire-Board.kicad_sch, part in row 2, column 2]

Parts:
C1, C9, C15, C18, C21, C26, C29, C30, C31, C36, C37, C38, C41, C42, C44, C45, C46, C47, C48, C49, C50, C51, C52, C53, C54, C55, C60, C61, C66, C67, C68, C74, C75, C76, C78, C79: 0.1u; C_0402_1005Metric
C2, C3, C5, C6, C11, C20, C22, C24, C72, C73, C77: 4.7u; C_1206_3216Metric
C4, C12, C14, C17, C39, C43, C69, C70, C71, C80: 1u; C_0603_1608Metric
C7, C40, C56, C57, C58, C59, C62, C63, C64, C65: 10n; C_0402_1005Metric
C8, C10: 220n; C_0805_2012Metric
C13: 270n; C_0402_1005Metric
C16: 100p; C_0402_1005Metric
C19: CFF; C_0603_1608Metric; not fitted
C23, C25, C27, C28, C32: 22u; C_1206_3216Metric
C33, C34: 10p; C_0402_1005Metric
C35: 10u; C_1210_3225Metric
CR1: B1100-13-F; Shottkey_Rev_Bat
CR3: USBLC6-2SC6; ESDPROTECTION; MPN USBLC6-2SC6
CR4: SMLVT3V3; SWD_1_TVS
CR5: ESDALC6V1W5; SWD_4_TVS
CR6, CR7, CR8, CR9: SP1233-01ETG; TVS_Input
D1, D2, D3, D4, D5, D8, D9, D12, D13, D14, D15, D16, D17, D18, D19, D20, D21, D22, D23, D26, D27, D28, D29, D30, D31, D32, D33, D34, D35, D36: TPD1E05U06DPYR; SD_ESD
D6, D7, D10, D11: BAT54S; dual_shottkey; PARTREV 2.3; DigiKey_Part_Number 4786-BAT54SCT-ND
D24: SMBJ15A; 15V_TVS; Mouser Part Number 576-SMBJ15A
D25: SMBJ18A; 18V_TVS; Mouser Part Number 576-SMBJ18A
F1: SF-1206S100-2; fuse; Mouser Part Number 652-SF-1206S100-2
H1, H2, H3, H4: MountingHole; MountingHole_3.2mm_M3
J1: Conn_01x02; AMASS_XT60-M_1x02_P7.20mm_Vertical
J2: BCS-103-L-D-TE; 3x2_Header; PARTREV R
J3: UART1; PinSocket_1x04_P2.54mm_Vertical
J4: UART3; PinSocket_1x04_P2.54mm_Vertical
J5, J7, J9, J10: SM03B-GHS-TB; 3-pin-jst
J6: USB4105-GF-A-060; USB; PARTREV B3
J11, J12, J13, J14: 1725656; screw_terminal; PARTREV 03.03.2021
J15: Conn_01x08; PinSocket_1x08_P2.54mm_Vertical
J16: C36191; PinSocket_2x06_P2.54mm_Vertical
J17: 1040310811; newSD
L1, L2: IHLP2525CZER220M5A; 22uH
LED1, LED2, LED3, LED4, LED5, LED6: LTST-C190KRKT; red_LED
R1, R14, R15, R28, R29, R35, R42, R61, R71, R79, R91, R92: 130; R_0805_2012Metric
R2, R68: 590; R_0402_1005Metric
R3, R4: 5.1k; R_0603_1608Metric; MPN 0603WAF5101T5E
R5: 43.2k; R_0402_1005Metric
R6, R10, R11, R65, R66, R74: 100k; R_0402_1005Metric
R7: 24.9k; R_0402_1005Metric
R8: 1.3k; R_1206_3216Metric
R9, R12, R37, R38, R39, R40, R63, R69, R72, R75, R76, R77, R78: 10k; R_0402_1005Metric
R13: 400; R_0603_1608Metric; MPN PAT0603E4000BST1
R16, R17, R18, R19, R20, R21: 22; R_0402_1005Metric
R22, R23, R24, R27, R32, R33: 47k; R_0402_1005Metric
R25, R26, R34, R41: 20; R_1206_3216Metric
R30, R31, R36, R43, R67, R70, R73: 4.7k; R_0402_1005Metric
R44, R45, R46, R47, R48, R49, R50, R51, R52, R53, R54, R55, R56, R57, R58, R59, R60, R80, R81, R82, R83, R84, R85, R86, R87, R88, R89, R90: 100; R_0402_1005Metric
R62, R64: 68.1k; R_0402_1005Metric
SW1: RESET; SWITCH
SW2: BOOT; SWITCH
U1: LMR36006BRNXR; 3.3V_Buck
U2: TPS55340PWPR; 15V_Boost
U3: STM32L496RET6; STM32
U4: TPS2113APW; PowerMUXER.
U5: TLV75533PDRVR; newLDO
U6, U7, U8, U9: MAX31856MUD+; MAX
U10: SS34; Boost_Shottkey
U11: CD74HC154M96; 4-16-Multiplexer
U12: TPS26600PWPR; eFuse
Y1: 16MHz; Crystal_SMD_3225-4Pin_3.2x2.5mm

Connections:
3V3: C17.1, C35.1, C36.1, C37.1, C38.1, C39.1, C40.1, C41.1, C42.1, C43.1, C44.1, C48.1, C49.1, C50.1, C51.1, C52.1, C53.1, C54.1, C55.1, C69.2, C70.2, C71.2, C79.2, C80.2, CR4.1, D6.2, D7.2, D10.2, D11.2, D13.1 (I/O), D16.1 (I/O), D20.1 (I/O), J2.01, J3.4, J4.4, J15.8, J17.4 (VDD), R1.2, R9.1, R22.1, R23.2, R24.1, R27.1, R32.1, R33.1, R37.1, R38.1, R39.1, R40.1, R74.2, R75.1, R76.1, R77.1, R78.1, SW2.1, SW2.2, U3.1 (VBAT), U3.13 (VDDA/VREF+), U3.19 (VDD), U3.32 (VDD), U3.48 (VDDUSB), U3.64 (VDD), U5.1 (OUT), U6.5 (AVDD), U6.8 (DVDD), U7.5 (AVDD), U7.8 (DVDD), U8.5 (AVDD), U8.8 (DVDD), U9.5 (AVDD), U9.8 (DVDD), U11.24 (VCC)
5V0: C14.1, C31.1, C32.1, R79.2, U4.7 (OUT), U5.4 (EN), U5.6 (IN)
5V_BUCK: C19.1, C21.1, C23.1, C25.1, C27.1, C28.1, C29.2, L2.1, R6.1, R10.2, R71.2, U4.8 (IN1)
5V_USB: C1.2, C4.1, C11.1, C30.1, CR3.5, J6.A4_B9 (VBUS), J6.B4_A9 (VBUS__1), R11.1, R91.2, U4.6 (IN2)
15V0: C76.1, C77.1, D25.1 (K), J5.1, J7.1, J9.1, J10.1, J15.5, R8.2, U12.15 (OUT), U12.16 (OUT)
15V0_Boost: C18.1, C20.1, C22.1, C24.1, C72.1, C73.1, C74.1, R5.1, R65.1, U10.1 (CATHODE), U12.1 (IN), U12.2 (IN)
/A0: R75.2, U3.21 (PA5), U11.23 (A0)
/A1: R77.2, U3.22 (PA6), U11.22 (A1)
/A2: R78.2, U3.23 (PA7), U11.21 (A2)
/A3: R76.2, U3.24 (PC4), U11.20 (A3)
/BOOT: R12.1, SW2.3, SW2.4, U3.60 (PH3-BOOT0)
/CLK: R57.2, U3.34 (PB13), U6.10 (SCK), U7.10 (SCK), U8.10 (SCK), U9.10 (SCK)
/CS0: R37.2, U6.9 (*CS), U11.1 (*Y0)
/CS1: R38.2, U7.9 (*CS), U11.2 (*Y1)
/CS2: R39.2, U8.9 (*CS), U11.3 (*Y2)
/CS3: R40.2, U9.9 (*CS), U11.4 (*Y3)
/CS4: R80.1, U11.5 (*Y4)
/CS5: R81.1, U11.6 (*Y5)
/CS6: R82.1, U11.7 (*Y6)
/CS7: R83.1, U11.8 (*Y7)
/CS8: R84.1, U11.9 (*Y8)
/CS9: R85.1, U11.10 (*Y9)
/CS10: R90.1, U11.11 (*Y10)
/CS11: R89.1, U11.13 (*Y11)
/CS12: R88.1, U11.14 (*Y12)
/CS13: R87.1, U11.15 (*Y13)
/CS14: R86.1, U11.16 (*Y14)
/D+: CR3.4, U3.45 (PA12)
/D-: CR3.6, U3.44 (PA11)
/DATA_N: CR3.1, J6.A7 (DN1), J6.B7 (DN2)
/DATA_P: CR3.3, J6.A6 (DP1), J6.B6 (DP2)
/GPIO_OUT_0: R59.2, U3.26 (PB0)
/GPIO_OUT_1: R60.2, U3.25 (PC5)
/MISO: R56.2, U3.35 (PB14), U6.11 (SDO), U7.11 (SDO), U8.11 (SDO), U9.11 (SDO)
/MOSI: R58.2, U3.36 (PB15), U6.12 (SDI), U7.12 (SDI), U8.12 (SDI), U9.12 (SDI)
/NRST: C26.2, CR5.1 (I/O1), J2.05, R9.2, SW1.1, SW1.2, U3.7 (NRST)
/P0: C45.1, D6.3, R30.2, U3.8 (PC0)
/P1: C47.1, D10.3, R36.2, U3.9 (PC1)
/P2: C68.1, D11.3, R43.2, U3.10 (PC2)
/P3: C46.1, D7.3, R31.2, U3.11 (PC3)
/RX1: R53.2, U3.43 (PA10)
/RX3: R55.2, U3.30 (PB11)
/S1: D29.1 (I/O), J16.1, R80.2
/S2: D31.1 (I/O), J16.3, R81.2
/S3: D33.1 (I/O), J16.5, R82.2
/S4: D35.1 (I/O), J16.7, R83.2
/S5: D26.1 (I/O), J16.9, R84.2
/S6: D28.1 (I/O), J16.11, R85.2
/S7: D30.1 (I/O), J16.2, R86.2
/S8: D32.1 (I/O), J16.4, R87.2
/S9: D34.1 (I/O), J16.6, R88.2
/S10: D36.1 (I/O), J16.8, R89.2
/S11: D27.1 (I/O), J16.10, R90.2
/SD_CLK: D5.1 (I/O), R21.1, U3.53 (PC12)
/SD_CMD: D1.1 (I/O), R20.1, R22.2, U3.54 (PD2)
/SD_D0: D3.1 (I/O), R16.1, R24.2, U3.39 (PC8)
/SD_D1: D4.1 (I/O), R17.1, R27.2, U3.40 (PC9)
/SD_D2: D8.1 (I/O), R18.1, R32.2, U3.51 (PC10)
/SD_D3: D9.1 (I/O), R19.1, R33.2, U3.52 (PC11)
/SD_DET: D2.1 (I/O), J17.10 (SW_DETECT), R23.1, U3.38 (PC7)
/STATUS_LED: R61.2, U3.27 (PB1)
/SWCLK: CR5.4 (I/O3), J2.02, U3.49 (PA14)
/SWDIO: CR5.5 (I/O4), J2.04, U3.46 (PA13)
/SWO: CR5.3 (I/O2), J2.06, U3.55 (PB3)
/TX1: R52.2, U3.42 (PA9)
/TX3: R54.2, U3.29 (PB10)
ANODE: L1.1, U2.1 (SW), U2.2 (SW), U10.2 (ANODE)
BAT_FUSE: CR1.2, F1.2
BAT_IN: F1.1, J1.2
GND: C1.1, C2.2, C3.2, C4.2, C5.2, C6.2, C7.2, C8.1, C9.2, C10.1, C11.2, C12.2, C13.2, C14.2, C16.2, C17.2, C18.2, C20.2, C21.2, C22.2, C23.2, C24.2, C25.2, C26.1, C27.2, C28.2, C29.1, C30.2, C31.2, C32.2, C33.2, C34.2, C35.2, C36.2, C37.2, C38.2, C39.2, C40.2, C41.2, C42.2, C43.2, C44.2, C45.2, C46.2, C47.2, C48.2, C49.2, C50.2, C51.2, C52.2, C53.2, C54.2, C55.2, C56.1, C57.2, C58.1, C59.2, C62.1, C63.2, C64.1, C65.2, C68.2, C69.1, C70.1, C71.1, C72.2, C73.2, C74.2, C75.1, C76.2, C77.2, C78.2, C79.1, C80.1, CR3.2, CR4.2, CR5.2 (GND), CR6.1, CR7.1, CR8.1, CR9.1, D1.2 (GND), D2.2 (GND), D3.2 (GND), D4.2 (GND), D5.2 (GND), D6.1, D7.1, D8.2 (GND), D9.2 (GND), D10.1, D11.1, D12.2 (GND), D13.2 (GND), D14.2 (GND), D15.2 (GND), D16.2 (GND), D17.2 (GND), D18.2 (GND), D19.2 (GND), D20.2 (GND), D21.2 (GND), D22.2 (GND), D23.2 (GND), D24.2 (A), D25.2 (A), D26.2 (GND), D27.2 (GND), D28.2 (GND), D29.2 (GND), D30.2 (GND), D31.2 (GND), D32.2 (GND), D33.2 (GND), D34.2 (GND), D35.2 (GND), D36.2 (GND), J1.1, J2.03, J3.1, J4.1, J5.2, J6.A1_B12 (GND), J6.B1_A12 (GND__1), J6.SH1 (SHELL_GND), J6.SH2 (SHELL_GND__1), J6.SH3 (SHELL_GND__2), J6.SH4 (SHELL_GND__3), J7.2, J9.2, J10.2, J15.1, J16.12, J17.6 (VSS), J17.9 (SW_DETECT), LED1.1, LED2.1, LED3.1, LED4.1, LED5.1, LED6.1, R3.1, R4.1, R7.2, R10.1, R11.2, R12.2, R13.1, R28.1, R29.1, R35.1, R42.1, R63.2, R64.2, R70.1, R73.1, SW1.3, SW1.4, U1.1 (PGND), U1.6 (AGND), U1.11 (PGND), U2.6 (SYNC), U2.7 (AGND), U2.11 (NC), U2.12 (PGND), U2.13 (PGND), U2.14 (PGND), U2.15 (EPAD), U3.12 (VSSA/VREF-), U3.18 (VSS), U3.31 (VSS), U3.47 (VSS), U3.63 (VSS), U4.2 (EN_N), U4.3 (VSNS), U4.5 (GND), U5.3 (GND), U5.7 (PAD), U6.1 (AGND), U6.14 (DGND), U7.1 (AGND), U7.14 (DGND), U8.1 (AGND), U8.14 (DGND), U9.1 (AGND), U9.14 (DGND), U11.12 (GND), U11.18 (*E1), U11.19 (*E2), U12.6 (MODE), U12.8 (RTN), U12.9 (GND), U12.17 (PAD), Y1.2 (G), Y1.4 (G)
unnamed: C13.1, R2.2
unnamed: CR6.2, R25.1, R28.2, R30.1
unnamed: CR7.2, R26.1, R29.2, R31.1
unnamed: CR8.2, R34.1, R35.2, R36.1
unnamed: CR9.2, R41.1, R42.2, R43.1
unnamed: D12.1 (I/O), J3.2, R52.1
unnamed: D14.1 (I/O), J3.3, R53.1
unnamed: D15.1 (I/O), J4.3, R54.1
unnamed: D17.1 (I/O), J4.2, R55.1
unnamed: D18.1 (I/O), J15.3, R56.1
unnamed: D19.1 (I/O), J15.2, R57.1
unnamed: D21.1 (I/O), J15.4, R58.1
unnamed: D22.1 (I/O), J15.6, R59.1
unnamed: D23.1 (I/O), J15.7, R60.1
unnamed: J5.3, R25.2
unnamed: J6.A5 (CC1), R3.2
unnamed: J6.B5 (CC2), R4.2
unnamed: J7.3, R26.2
unnamed: J9.3, R34.2
unnamed: J10.3, R41.2
unnamed: J11.2, R45.2
unnamed: J12.2, R47.2
unnamed: J13.2, R49.2
unnamed: J14.2, R51.2
unnamed: J17.2 (CD/DAT3), R19.2
unnamed: J17.5 (CLK), R21.2
unnamed: J17.3 (CMD), R20.2
unnamed: J17.7 (DAT0), R16.2
unnamed: J17.8 (DAT1), R17.2
unnamed: J17.1 (DAT2), R18.2
unnamed: LED1.2, R1.1
unnamed: LED2.2, R8.1
unnamed: LED3.2, R14.1
unnamed: LED4.2, R15.1
unnamed: LED5.2, R61.1
unnamed: LED6.2, R92.1
unnamed: R5.2, R62.1
unnamed: R14.2, R71.1
unnamed: R15.2, R79.1
unnamed: R65.2, R66.1
unnamed: R67.1, R68.1
unnamed: R69.2, R70.2
unnamed: R72.2, R73.2
unnamed: R91.1, R92.2
unnamed: C15.1, U1.4 (BST)
unnamed: C19.2, R6.2, R7.1, U1.7 (FB)
unnamed: C12.1, U1.5 (VCC)
unnamed: C16.1, R2.1, U2.8 (COMP)
unnamed: R62.2, R63.1, U2.9 (FB)
unnamed: R64.1, U2.10 (FREQ)
unnamed: C7.1, U2.5 (SS)
unnamed: C33.1, U3.5 (PH0-OSC_IN), Y1.1
unnamed: C34.1, U3.6 (PH1-OSC_OUT), Y1.3
unnamed: R13.2, U4.4 (ILIM)
unnamed: J11.1, R44.2, U6.2 (BIAS)
unnamed: C57.1, C60.2, R45.1, U6.4 (T+)
unnamed: C56.2, C60.1, R44.1, U6.3 (T-)
unnamed: J12.1, R46.2, U7.2 (BIAS)
unnamed: C59.1, C61.2, R47.1, U7.4 (T+)
unnamed: C58.2, C61.1, R46.1, U7.3 (T-)
unnamed: J13.1, R48.2, U8.2 (BIAS)
unnamed: C63.1, C66.2, R49.1, U8.4 (T+)
unnamed: C62.2, C66.1, R48.1, U8.3 (T-)
unnamed: J14.1, R50.2, U9.2 (BIAS)
unnamed: C65.1, C67.2, R51.1, U9.4 (T+)
unnamed: C64.2, C67.1, R50.1, U9.3 (T-)
unnamed: C75.2, U12.12 (DVDT)
unnamed: R72.1, U12.11 (ILIM)
unnamed: R68.2, R69.1, U12.5 (OVP)
unnamed: C78.1, R74.1, U12.7 (SHDN_N)
unnamed: R66.2, R67.2, U12.3 (UVLO)
SW: C15.2, L2.2, U1.3 (NC), U1.12 (SW)
VBAT: C2.1, C3.1, C5.1, C6.1, C8.2, C9.1, C10.2, CR1.1, D24.1 (K), L1.2, U1.2 (VIN), U1.9 (EN), U1.10 (VIN), U2.3 (VIN), U2.4 (EN)

Notes on the sheet:
SPI CS
Thermocouple Amps
STM32 + LDO + USB-C
UART1
POWER PATH
UART2
SD CARD
SPI
Pressure Transducer Inputs
Breakout Periferals

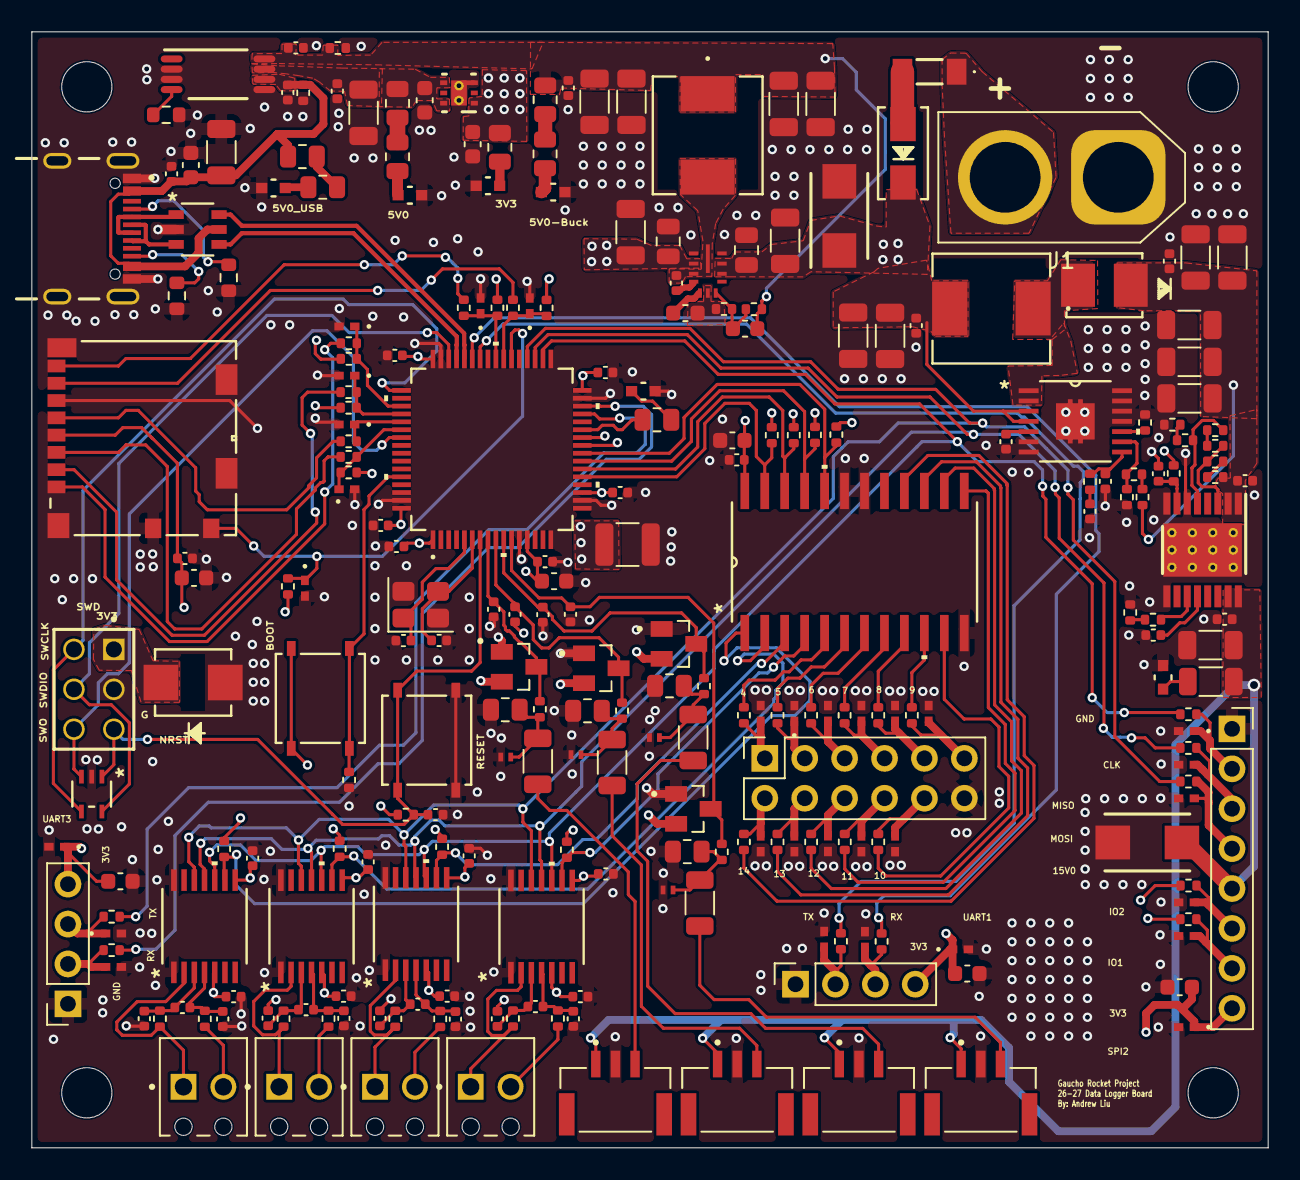
[picture p61: board Hotfire-Board.kicad_pcb from above]

Board: 4 copper layers, 78.7 x 71.0 mm, 260 parts (0 on the bottom side), 143 nets.
