Gaucho-Rocket-Project/Hotfire-Board/firmware/src/shell/daq.cpp

#include <zephyr/kernel.h>
#include <zephyr/shell/shell.h>

#include <errno.h>
#include <stddef.h>
#include <stdint.h>
#include <stdio.h>

#include "shell/daq.hpp"

#include <zephyr/device.h>
#include <zephyr/devicetree.h>
#include <zephyr/drivers/gpio.h>

#include <errno.h>
#include <string.h>

#include "drivers/thermocouples.hpp"
#include "drivers/pressure.hpp"
#include "app/sensor_logging.hpp"
#include "drivers/sd.hpp"

namespace {

K_MUTEX_DEFINE(binding_mutex);

Thermocouples* tc_driver = nullptr;
PressureTransducers* pressure_driver = nullptr;

// Format milli-degrees Celsius without floating point.
void format_temperature(int32_t temperature_mc, char* buffer, size_t size)
{
    int64_t magnitude =
        temperature_mc < 0
            ? -static_cast<int64_t>(temperature_mc)
            : static_cast<int64_t>(temperature_mc);

    snprintf(
        buffer,
        size,
        "%s%lld.%03lld C",
        temperature_mc < 0 ? "-" : "",
        static_cast<long long>(magnitude / 1000),
        static_cast<long long>(magnitude % 1000)
    );
}

int cmd_daq_tc(const struct shell* sh, size_t argc, char** argv)
{
    ARG_UNUSED(argc);
    ARG_UNUSED(argv);

    k_mutex_lock(&binding_mutex, K_FOREVER);
    Thermocouples* driver = tc_driver;
    k_mutex_unlock(&binding_mutex);

    if (driver == nullptr) {
        shell_error(
            sh,
            "MAX31856 driver not initialized"
        );
        return -ENODEV;
    }

    shell_print(sh, "");
    shell_print(sh, "MAX31856 Thermocouple Measurements");
    shell_print(sh, "-----------------------------------------");

    int first_error = 0;

    for (size_t ch = 0;
         ch < Thermocouples::CHANNEL_COUNT;
         ++ch) {

        int32_t cj_temperature_mc = 0;

        int cj_ret = driver->read_cold_junction(
            ch,
            cj_temperature_mc
        );

        Thermocouples::Reading reading{};
        int tc_ret = driver->read(ch, reading);

        char internal_text[32]{};
        char external_text[64]{};

        // Internal cold-junction temperature
        if (cj_ret == 0) {
            format_temperature(
                cj_temperature_mc,
                internal_text,
                sizeof(internal_text)
            );
        } else {
            snprintf(
                internal_text,
                sizeof(internal_text),
                "READ ERROR (%d)",
                cj_ret
            );

            if (first_error == 0) {
                first_error = cj_ret;
            }
        }

        // External thermocouple temperature
        if (reading.valid) {
            format_temperature(
                reading.temperature_mc,
                external_text,
                sizeof(external_text)
            );
        }
        else if (reading.fault & 0x01U) {
            snprintf(
                external_text,
                sizeof(external_text),
                "NOT CONNECTED"
            );
        }
        else if (reading.fault != 0) {
            snprintf(
                external_text,
                sizeof(external_text),
                "INVALID (fault 0x%02X)",
                static_cast<unsigned>(reading.fault)
            );
        }
        else {
            snprintf(
                external_text,
                sizeof(external_text),
                "READ ERROR (%d)",
                tc_ret
            );

            if (first_error == 0 && tc_ret < 0) {
                first_error = tc_ret;
            }
        }

        shell_print(
            sh,
            "TC%u",
            static_cast<unsigned>(ch + 1)
        );

        shell_print(
            sh,
            "  Internal:     %s",
            internal_text
        );

        shell_print(
            sh,
            "  Thermocouple: %s",
            external_text
        );

        shell_print(
            sh,
            "  Fault:        0x%02X",
            static_cast<unsigned>(reading.fault)
        );

        shell_print(sh, "");
    }

    return first_error;
}


int cmd_daq_pressure(const struct shell* sh, size_t argc, char** argv)
{
    ARG_UNUSED(argc);
    ARG_UNUSED(argv);

    k_mutex_lock(&binding_mutex, K_FOREVER);
    PressureTransducers* driver = pressure_driver;
    k_mutex_unlock(&binding_mutex);

    if (driver == nullptr) {
        shell_error(sh, "Pressure ADC driver not initialized");
        return -ENODEV;
    }

    PressureTransducers::Reading readings[PressureTransducers::CHANNEL_COUNT]{};
    uint8_t valid_mask = 0;
    const int ret = driver->read_all(readings, valid_mask);
    static constexpr unsigned connectors[] = {5, 9, 10, 7};
    static_assert(ARRAY_SIZE(connectors) == PressureTransducers::CHANNEL_COUNT);

    shell_print(sh, "");
    shell_print(sh, "Pressure Transducer ADC Measurements (130 ohm shunts)");
    shell_print(sh, "-----------------------------------------");
    for (size_t ch = 0; ch < PressureTransducers::CHANNEL_COUNT; ++ch) {
        shell_print(sh, "P%u (J%u, PC%u / ADC1 IN%u, CSV p%u)",
                    static_cast<unsigned>(ch), connectors[ch],
                    static_cast<unsigned>(ch), static_cast<unsigned>(ch + 1),
                    static_cast<unsigned>(ch + 1));
        if ((valid_mask & (1U << ch)) == 0) {
            shell_print(sh, "  ADC:     READ ERROR (%d)", ret < 0 ? ret : -EIO);
        } else {
            const auto& reading = readings[ch];
            const int64_t magnitude = reading.current_ua < 0
                ? -static_cast<int64_t>(reading.current_ua) : reading.current_ua;
            shell_print(sh, "  Raw:     %u / 4095", static_cast<unsigned>(reading.raw));
            shell_print(sh, "  Current: %s%lld.%03lld mA (%ld uA)",
                        reading.current_ua < 0 ? "-" : "",
                        static_cast<long long>(magnitude / 1000),
                        static_cast<long long>(magnitude % 1000),
                        static_cast<long>(reading.current_ua));
            shell_print(sh, "  Range:   %s",
                        reading.current_ua < 4000 ? "BELOW 4 mA" :
                        reading.current_ua > 20000 ? "ABOVE 20 mA" : "WITHIN 4-20 mA");
        }
        shell_print(sh, "");
    }
    return ret;
}

int run_live_display(const struct shell* sh, size_t argc, char** argv,
                     shell_cmd_handler handler, const char* title, const char* stopped)
{
    // Use the terminal's alternate screen to preserve command history and
    // redraw in place instead of appending a new table every second.
    shell_fprintf_normal(sh, "\033[?1049h\033[2J\033[H");
    int result = 0;

    while (true) {
        shell_fprintf_normal(sh, "\033[H\033[2J");
        shell_print(sh, "%s (1 Hz) -- Enter or Ctrl+C to stop", title);
        // Keep refreshing after a sensor read error; the table reports it.
        (void)handler(sh, argc, argv);

        uint8_t input[2];
        const int ret = shell_readline(sh, input, sizeof(input), K_SECONDS(1));
        if (ret == -ETIMEDOUT) {
            continue;
        }
        // Any completed line or Ctrl+C exits. ENOBUFS means a line longer
        // than the tiny stop buffer was entered, which also requests exit.
        if (ret < 0 && ret != -ECANCELED && ret != -ENOBUFS) {
            result = ret;
        }
        break;
    }

    shell_fprintf_normal(sh, "\033[?1049l");
    shell_print(sh, "%s", stopped);
    return result;
}

int cmd_daq_tc_live(const struct shell* sh, size_t argc, char** argv)
{
    k_mutex_lock(&binding_mutex, K_FOREVER);
    const bool available = tc_driver != nullptr;
    k_mutex_unlock(&binding_mutex);
    if (!available) {
        shell_error(sh, "MAX31856 driver not initialized");
        return -ENODEV;
    }
    return run_live_display(sh, argc, argv, cmd_daq_tc, "Live thermocouples",
                            "Live thermocouple display stopped");
}

int cmd_daq_pressure_live(const struct shell* sh, size_t argc, char** argv)
{
    k_mutex_lock(&binding_mutex, K_FOREVER);
    const bool available = pressure_driver != nullptr;
    k_mutex_unlock(&binding_mutex);
    if (!available) {
        shell_error(sh, "Pressure ADC driver not initialized");
        return -ENODEV;
    }
    return run_live_display(sh, argc, argv, cmd_daq_pressure, "Live pressure ADC readings",
                            "Live pressure ADC display stopped");
}


static int cmd_daq_log_start(
    const struct shell* sh,
    size_t argc,
    char** argv)
{
    ARG_UNUSED(argc);
    ARG_UNUSED(argv);

    int ret = sensor_logging::start();

    if (ret < 0) {
        shell_error(
            sh,
            "Cannot start logging: %d",
            ret
        );
        return ret;
    }

    (void)storage::log_status(
        storage::LogLevel::Info,
        "Sensor logging started"
    );

    auto sd = storage::get_status();

    shell_print(
        sh,
        "Logging targets: temperature 10 Hz, pressure 1000 Hz"
    );

    if (!sd.mounted) {
        shell_warn(
            sh,
            "SD not mounted: buffering in RAM only"
        );
    }

    return 0;
}

static int cmd_daq_log_stop(
    const struct shell* sh,
    size_t argc,
    char** argv)
{
    ARG_UNUSED(argc);
    ARG_UNUSED(argv);

    int ret = sensor_logging::stop();

    if (ret < 0) {
        shell_error(
            sh,
            "Stop or SD flush failed: %d",
            ret
        );
        return ret;
    }

    (void)storage::log_status(
        storage::LogLevel::Info,
        "Sensor logging stopped"
    );

    auto stats = sensor_logging::get_stats();
    auto sd = storage::get_status();

    shell_print(sh, "Sensor logging stopped");

    shell_print(sh, "Temperature frames: %llu; pressure frames: %llu",
                static_cast<unsigned long long>(stats.temperature.samples),
                static_cast<unsigned long long>(stats.pressure.samples));

    if (!sd.mounted) {
        shell_warn(
            sh,
            "SD not mounted; samples remain in RAM"
        );
    } else if (sd.pending_samples > 0) {
        shell_warn(
            sh,
            "%u samples still pending",
            static_cast<unsigned>(sd.pending_samples)
        );
    } else {
        shell_print(sh, "Pending sensor records flushed");
    }

    return 0;
}

void print_stream_timing(const shell* sh, const char* name, unsigned target_hz,
                         const sensor_logging::StreamStats& stats)
{
    const uint64_t rate = stats.rate_millihz();
    shell_print(sh, "%s: target %u Hz, measured %llu.%03llu frames/s", name, target_hz,
                static_cast<unsigned long long>(rate / 1000),
                static_cast<unsigned long long>(rate % 1000));
    shell_print(sh, "  Frames: %llu; all-channel-valid: %llu; read errors: %llu (last %d)",
                static_cast<unsigned long long>(stats.samples),
                static_cast<unsigned long long>(stats.valid_frames),
                static_cast<unsigned long long>(stats.read_errors), stats.last_error);
    shell_print(sh, "  Acquisition us: last %u, average %llu, max %u",
                stats.acquisition_us,
                static_cast<unsigned long long>(stats.samples ? stats.acquisition_sum_us / stats.samples : 0),
                stats.max_acquisition_us);
    shell_print(sh, "  Capture + enqueue us: last %u, average %llu, max %u",
                stats.total_us,
                static_cast<unsigned long long>(stats.samples ? stats.total_sum_us / stats.samples : 0),
                stats.max_total_us);
    shell_print(sh, "  Start interval us: last %llu, max %llu",
                static_cast<unsigned long long>(stats.interval_us),
                static_cast<unsigned long long>(stats.max_interval_us));
    shell_print(sh, "  Missed periods: %llu; work overruns: %llu; queue drops: %llu",
                static_cast<unsigned long long>(stats.missed_periods),
                static_cast<unsigned long long>(stats.overruns),
                static_cast<unsigned long long>(stats.queue_drops));
}

static int cmd_daq_log_status(const struct shell* sh, size_t argc, char** argv)
{
    ARG_UNUSED(argc);
    ARG_UNUSED(argv);
    const auto stats = sensor_logging::get_stats();
    const auto sd = storage::get_status();
    shell_print(sh, "State: %s", stats.stopping ? "STOPPING" : stats.running ? "RUNNING" : "STOPPED");
    print_stream_timing(sh, "Temperature", 10, stats.temperature);
    print_stream_timing(sh, "Pressure", 1000, stats.pressure);
    shell_print(sh, "SD: %s; pending records: %u; dropped records (boot): %u",
                sd.mounted ? "MOUNTED" : "UNMOUNTED",
                static_cast<unsigned>(sd.pending_samples), sd.dropped_samples);
    shell_print(sh, "SD records synced (boot): %llu; batch errors: %u (last %d)",
                static_cast<unsigned long long>(sd.written_samples), sd.write_errors,
                sd.last_write_error);
    shell_print(sh, "SD batch format/write/sync us: last %u, max %u", sd.last_batch_us, sd.max_batch_us);
    return 0;
}


/*
 * Expansion GPIO interface
 *
 * GPIO 0: PB0 -> J15 pin 6
 * GPIO 1: PC5 -> J15 pin 7
 *
 * Only these two pins are exposed for general I/O.
 */

struct ExpansionGpio {
    const struct device* port;
    gpio_pin_t pin;
    const char* name;
    unsigned int header_pin;
    bool output;
};

static ExpansionGpio gpio_lines[] = {
    {
        DEVICE_DT_GET(DT_NODELABEL(gpiob)),
        0,
        "PB0",
        6,
        false
    },
    {
        DEVICE_DT_GET(DT_NODELABEL(gpioc)),
        5,
        "PC5",
        7,
        false
    }
};

K_MUTEX_DEFINE(expansion_gpio_mutex);

static bool expansion_gpio_initialized = false;

static int gpio_index(const char* name)
{
    if (strcmp(name, "0") == 0 ||
        strcmp(name, "PB0") == 0) {
        return 0;
    }

    if (strcmp(name, "1") == 0 ||
        strcmp(name, "PC5") == 0) {
        return 1;
    }

    return -EINVAL;
}

// Called with expansion_gpio_mutex held.
static int initialize_expansion_gpio()
{
    if (expansion_gpio_initialized) {
        return 0;
    }

    // Verify the GPIO controllers are ready.
    for (auto& line : gpio_lines) {
        if (!device_is_ready(line.port)) {
            return -ENODEV;
        }
    }

    // Default to inputs to avoid unexpectedly
    // driving external devices at startup.
    for (auto& line : gpio_lines) {
        int ret = gpio_pin_configure(
            line.port,
            line.pin,
            GPIO_INPUT
        );

        if (ret < 0) {
            return ret;
        }

        line.output = false;
    }

    expansion_gpio_initialized = true;
    return 0;
}

// daq gpio list
static int cmd_gpio_list(
    const struct shell* sh,
    size_t argc,
    char** argv)
{
    ARG_UNUSED(argc);
    ARG_UNUSED(argv);

    k_mutex_lock(
        &expansion_gpio_mutex,
        K_FOREVER
    );

    int ret = initialize_expansion_gpio();

    if (ret < 0) {
        k_mutex_unlock(&expansion_gpio_mutex);
        shell_error(sh, "GPIO init failed: %d", ret);
        return ret;
    }

    shell_print(sh, "Expansion GPIO (J15)");
    shell_print(sh, "---------------------------");

    for (unsigned int i = 0; i < 2; ++i) {
        auto& line = gpio_lines[i];

        int value = gpio_pin_get_raw(
            line.port,
            line.pin
        );

        if (value < 0) {
            shell_print(
                sh,
                "GPIO%u  %s  J15-%u  READ ERROR %d",
                i,
                line.name,
                line.header_pin,
                value
            );
            continue;
        }

        shell_print(
            sh,
            "GPIO%u  %s  J15-%u  %-6s %s",
            i,
            line.name,
            line.header_pin,
            line.output ? "OUTPUT" : "INPUT",
            value ? "HIGH" : "LOW"
        );
    }

    k_mutex_unlock(&expansion_gpio_mutex);

    shell_print(sh, "");
    return 0;
}

// daq gpio read <id>
static int cmd_gpio_read(
    const struct shell* sh,
    size_t argc,
    char** argv)
{
    if (argc != 2) {
        shell_error(sh, "Usage: daq gpio read <0|1>");
        return -EINVAL;
    }

    int index = gpio_index(argv[1]);

    if (index < 0) {
        shell_error(sh, "Unknown GPIO: %s", argv[1]);
        return -EINVAL;
    }

    k_mutex_lock(
        &expansion_gpio_mutex,
        K_FOREVER
    );

    int ret = initialize_expansion_gpio();

    if (ret == 0) {
        ret = gpio_pin_get_raw(
            gpio_lines[index].port,
            gpio_lines[index].pin
        );
    }

    k_mutex_unlock(&expansion_gpio_mutex);

    if (ret < 0) {
        shell_error(sh, "GPIO read failed: %d", ret);
        return ret;
    }

    shell_print(
        sh,
        "%s = %s (%d)",
        gpio_lines[index].name,
        ret ? "HIGH" : "LOW",
        ret
    );

    return 0;
}

// daq gpio write <id> <0|1>
static int cmd_gpio_write(
    const struct shell* sh,
    size_t argc,
    char** argv)
{
    if (argc != 3) {
        shell_error(
            sh,
            "Usage: daq gpio write <0|1> <0|1>"
        );
        return -EINVAL;
    }

    int index = gpio_index(argv[1]);

    if (index < 0) {
        shell_error(sh, "Unknown GPIO: %s", argv[1]);
        return -EINVAL;
    }

    int value;

    if (strcmp(argv[2], "0") == 0) {
        value = 0;
    } else if (strcmp(argv[2], "1") == 0) {
        value = 1;
    } else {
        shell_error(sh, "Value must be 0 or 1");
        return -EINVAL;
    }

    k_mutex_lock(
        &expansion_gpio_mutex,
        K_FOREVER
    );

    int ret = initialize_expansion_gpio();

    if (ret == 0) {
        auto& line = gpio_lines[index];

        if (!line.output) {
            // Configure as output with the requested
            // initial level to avoid a LOW glitch.
            ret = gpio_pin_configure(
                line.port,
                line.pin,
                value ? GPIO_OUTPUT_HIGH
                      : GPIO_OUTPUT_LOW
            );

            if (ret == 0) {
                line.output = true;
            }
        } else {
            ret = gpio_pin_set_raw(
                line.port,
                line.pin,
                value
            );
        }
    }

    k_mutex_unlock(&expansion_gpio_mutex);

    if (ret < 0) {
        shell_error(sh, "GPIO write failed: %d", ret);
        return ret;
    }

    shell_print(
        sh,
        "%s set %s",
        gpio_lines[index].name,
        value ? "HIGH" : "LOW"
    );

    return 0;
}

// daq gpio input <id>
static int cmd_gpio_input(
    const struct shell* sh,
    size_t argc,
    char** argv)
{
    if (argc != 2) {
        shell_error(sh, "Usage: daq gpio input <0|1>");
        return -EINVAL;
    }

    int index = gpio_index(argv[1]);

    if (index < 0) {
        shell_error(sh, "Unknown GPIO: %s", argv[1]);
        return -EINVAL;
    }

    k_mutex_lock(
        &expansion_gpio_mutex,
        K_FOREVER
    );

    int ret = initialize_expansion_gpio();

    if (ret == 0) {
        auto& line = gpio_lines[index];

        ret = gpio_pin_configure(
            line.port,
            line.pin,
            GPIO_INPUT
        );

        if (ret == 0) {
            line.output = false;
        }
    }

    k_mutex_unlock(&expansion_gpio_mutex);

    if (ret < 0) {
        shell_error(sh, "GPIO input failed: %d", ret);
        return ret;
    }

    shell_print(
        sh,
        "%s configured as INPUT",
        gpio_lines[index].name
    );

    return 0;
}


// Register "daq log start|stop|status".
SHELL_STATIC_SUBCMD_SET_CREATE(
    daq_log_commands,
    SHELL_CMD_ARG(
        start, NULL, "Start temperature (10 Hz) and pressure (1000 Hz) logging",
        cmd_daq_log_start, 1, 0
    ),
    SHELL_CMD_ARG(
        stop, NULL, "Stop sensor logging and flush pending records",
        cmd_daq_log_stop, 1, 0
    ),
    SHELL_CMD_ARG(
        status, NULL, "Show sensor logging and buffer status",
        cmd_daq_log_status, 1, 0
    ),
    SHELL_SUBCMD_SET_END
);

// GPIO subcommands.
SHELL_STATIC_SUBCMD_SET_CREATE(
    daq_gpio_commands,
    SHELL_CMD(
        list,
        NULL,
        "List expansion GPIO pins",
        cmd_gpio_list
    ),
    SHELL_CMD_ARG(
        read,
        NULL,
        "Read GPIO: read <0|1>",
        cmd_gpio_read,
        2,
        0
    ),
    SHELL_CMD_ARG(
        write,
        NULL,
        "Write GPIO: write <0|1> <0|1>",
        cmd_gpio_write,
        3,
        0
    ),
    SHELL_CMD_ARG(
        input,
        NULL,
        "Set GPIO to input: input <0|1>",
        cmd_gpio_input,
        2,
        0
    ),
    SHELL_SUBCMD_SET_END
);

// Register sensor, logging, and GPIO commands under one DAQ root.
SHELL_STATIC_SUBCMD_SET_CREATE(
    daq_commands,
    SHELL_CMD(
        log,
        &daq_log_commands,
        "Sensor logging controls",
        NULL
    ),
    SHELL_CMD(
        tc,
        NULL,
        "Read internal and external temperatures",
        cmd_daq_tc
    ),
    SHELL_CMD_ARG(
        tc_live,
        NULL,
        "Live temperatures at 1 Hz; Enter or Ctrl+C to stop",
        cmd_daq_tc_live,
        1,
        0
    ),
    SHELL_CMD_ARG(
        pressure,
        NULL,
        "Read pressure ADC counts and loop currents",
        cmd_daq_pressure,
        1,
        0
    ),
    SHELL_CMD_ARG(
        pressure_live,
        NULL,
        "Live pressure ADC readings at 1 Hz; Enter or Ctrl+C to stop",
        cmd_daq_pressure_live,
        1,
        0
    ),
    SHELL_CMD(
        gpio,
        &daq_gpio_commands,
        "Expansion GPIO read/write",
        NULL
    ),
    SHELL_SUBCMD_SET_END
);

SHELL_CMD_REGISTER(
    daq,
    &daq_commands,
    "DAQ diagnostics and controls",
    NULL
);

} // anonymous namespace

void daq_shell_bind_thermocouples(
    Thermocouples& thermocouples)
{
    k_mutex_lock(&binding_mutex, K_FOREVER);
    tc_driver = &thermocouples;
    k_mutex_unlock(&binding_mutex);
}

void daq_shell_bind_pressure(PressureTransducers& pressure)
{
    k_mutex_lock(&binding_mutex, K_FOREVER);
    pressure_driver = &pressure;
    k_mutex_unlock(&binding_mutex);
}
