Gaucho-Rocket-Project/Hotfire-Board/(commit log)

2026-10-07 update schematic
    [15V_Buck.stp, 15uH_Inductor.step, 28V_TVS.step, 2x3_Header.stp, 3.3V_Buck.stp, ESDPROTECTION.step, Hotfire-Board.kicad_pcb, Hotfire-Board.kicad_sch]
2026-10-08 finished layout
    [Hotfire-Board.kicad_pcb, Hotfire-Board.kicad_sch, SD_Card.step, SD_ESD.step, SD_Module.stp, TVS_Input.step, bom.csv, designators.csv]
2026-10-08 order read
    [Hotfire-Board.kicad_pcb, Hotfire-Board.kicad_sch, bom.csv, designators.csv, positions.csv]
2026-10-14 reworked power poath, added cs multiplexer
2026-11-04 kicad 10.0 update
2026-11-10 implemented logging via uart
2026-11-11 implemented dynamic sd mounting
2026-11-12 added pressure transducer
2026-11-13 implemented spi and uart dma
2026-11-13 implemented DMA spi
