Gaucho-Rocket-Project/Hotfire-Board/(notices)

Notices in the files:
hotfire-board/Project Libraries/My3DModels/2x3_Header.stp:
author */ ('License CC BY-ND 4.0'),
